openvalence/Hardware/flagship/ossm-flagship.kicad_sch

## KiCad design flagship/ossm-flagship.kicad_sch (2026-09-24)

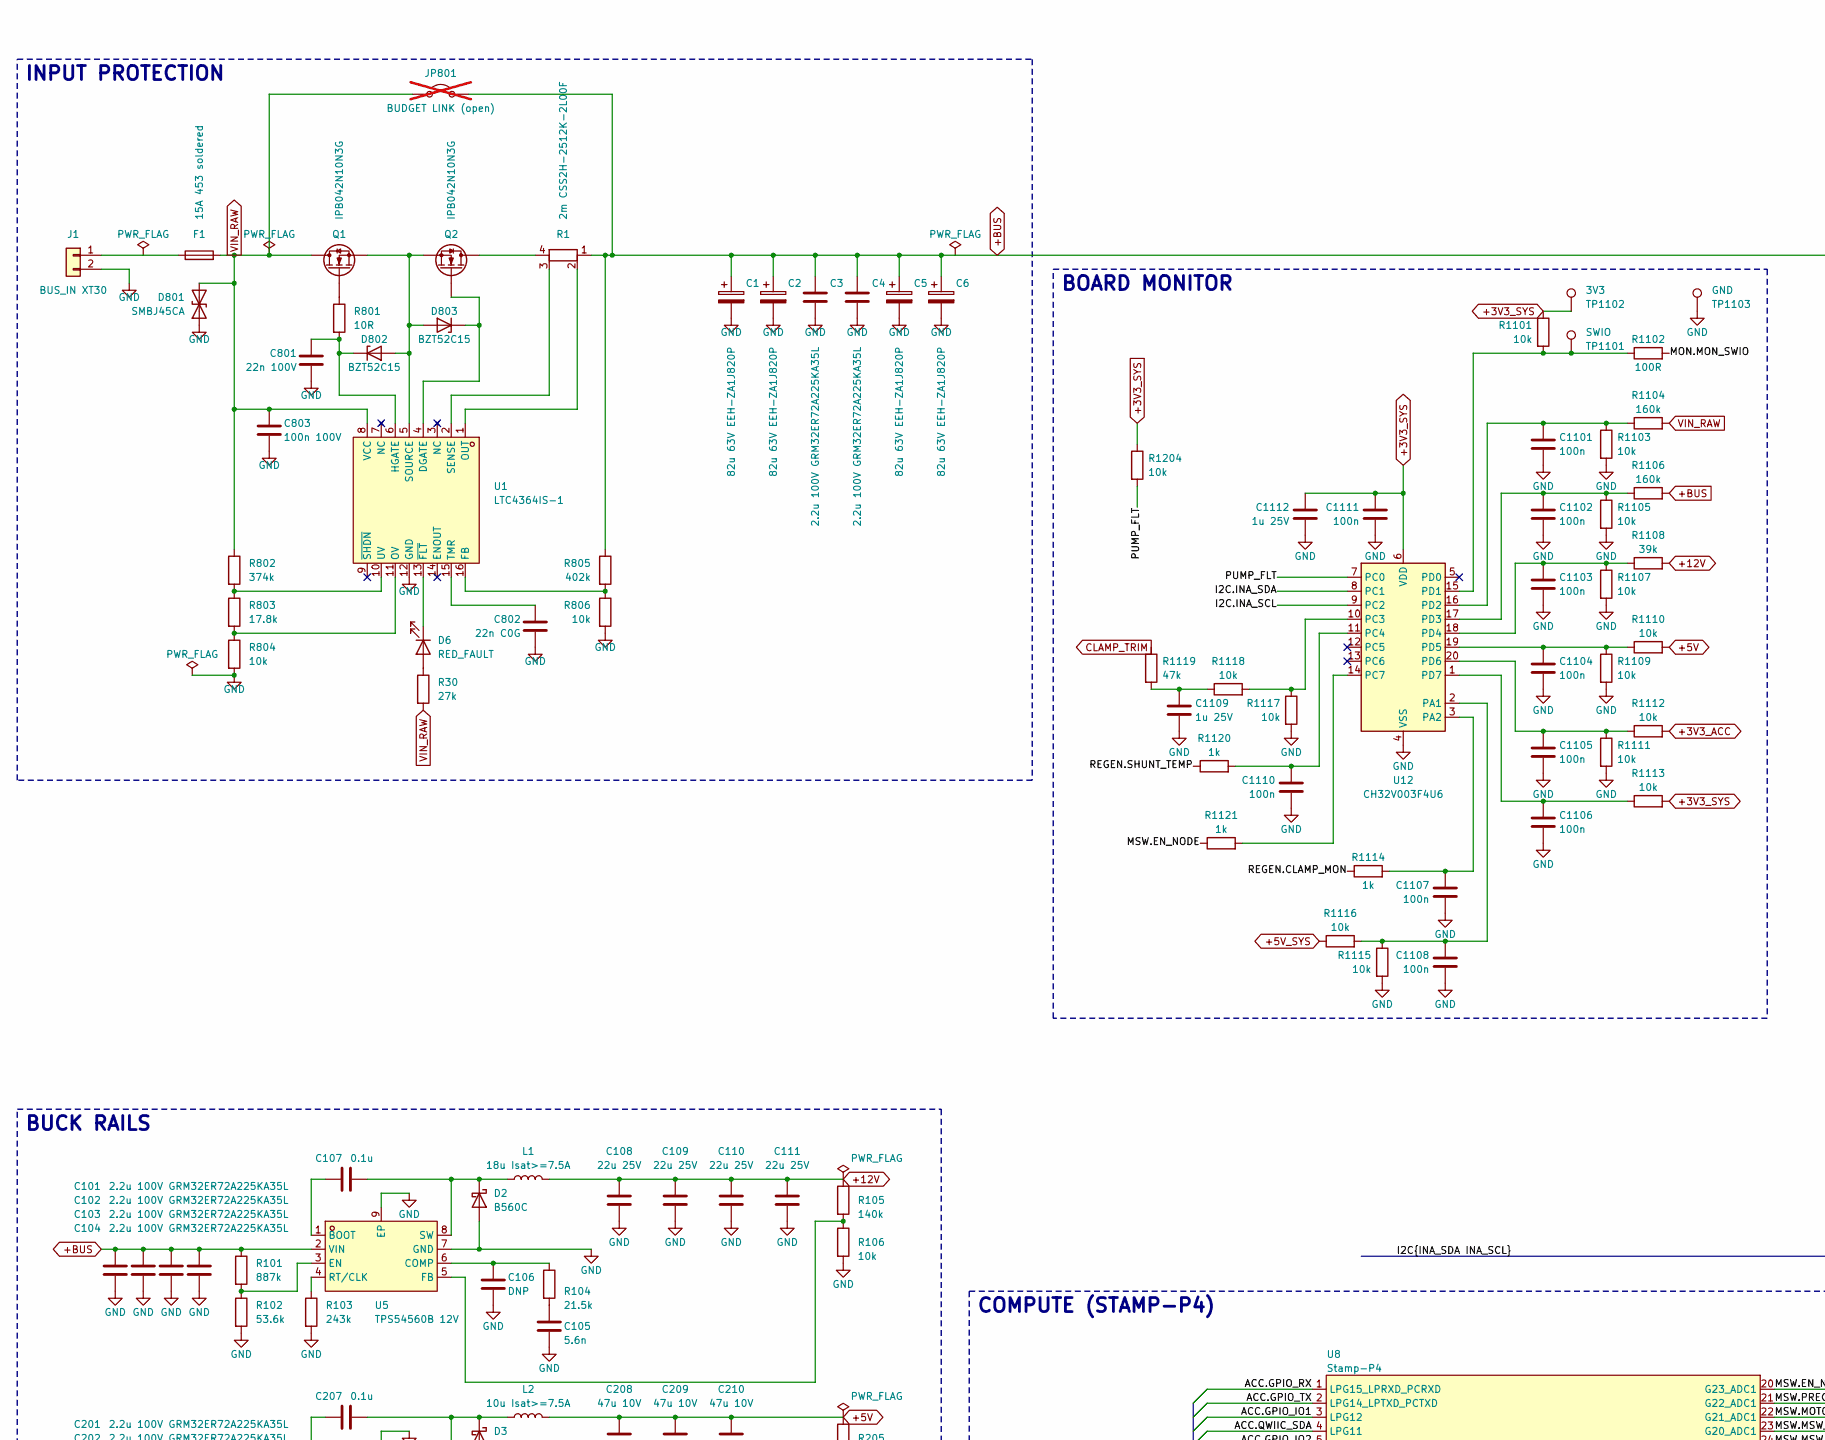
[picture p1: schematic ossm-flagship.kicad_sch, part in row 1, column 1]

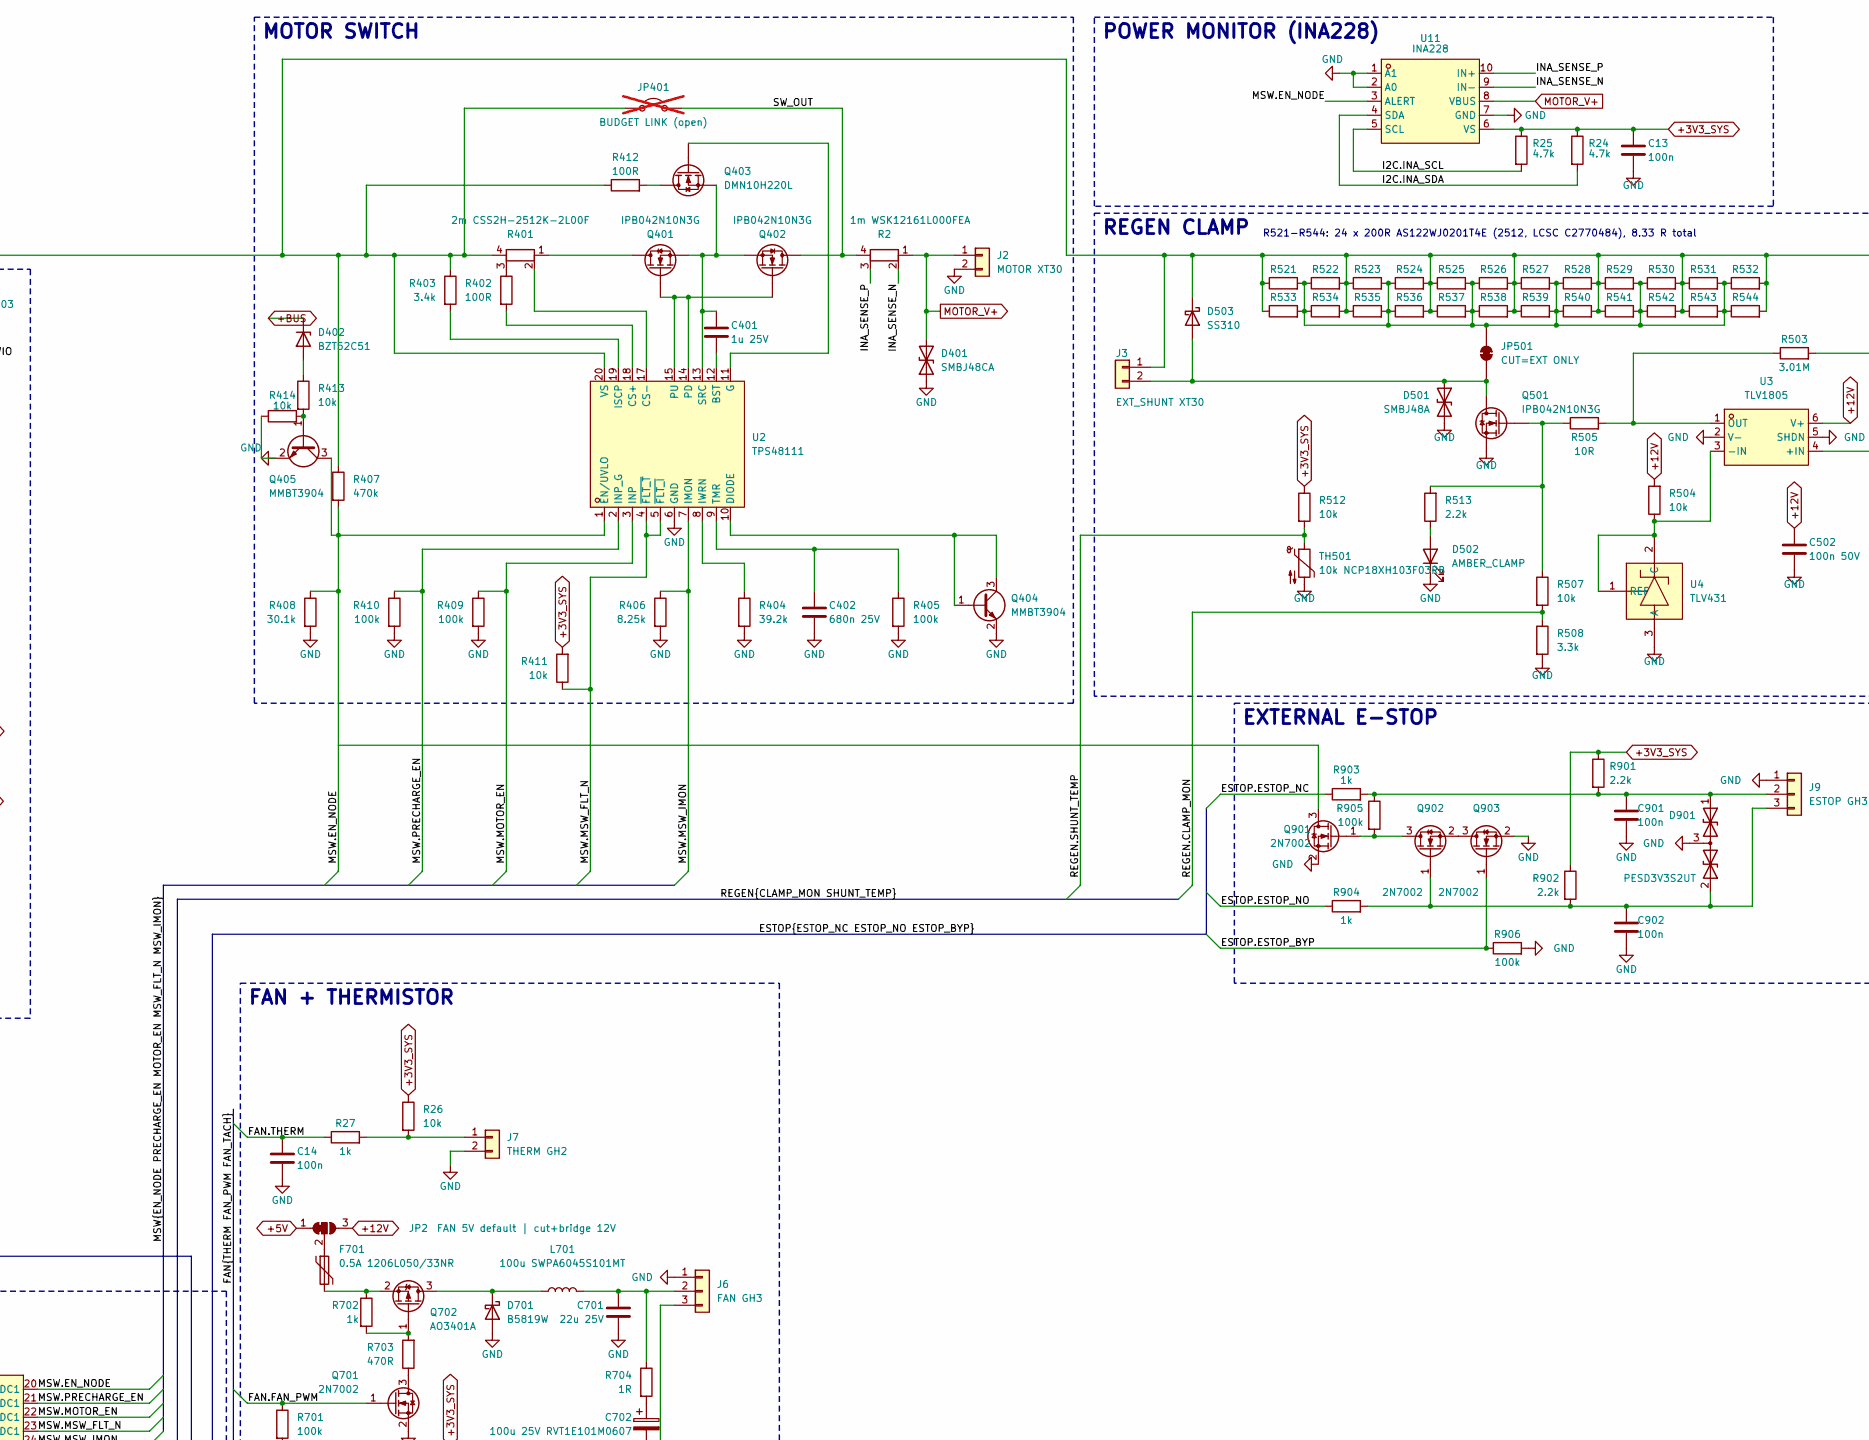
[picture p2: schematic ossm-flagship.kicad_sch, part in row 1, column 2]

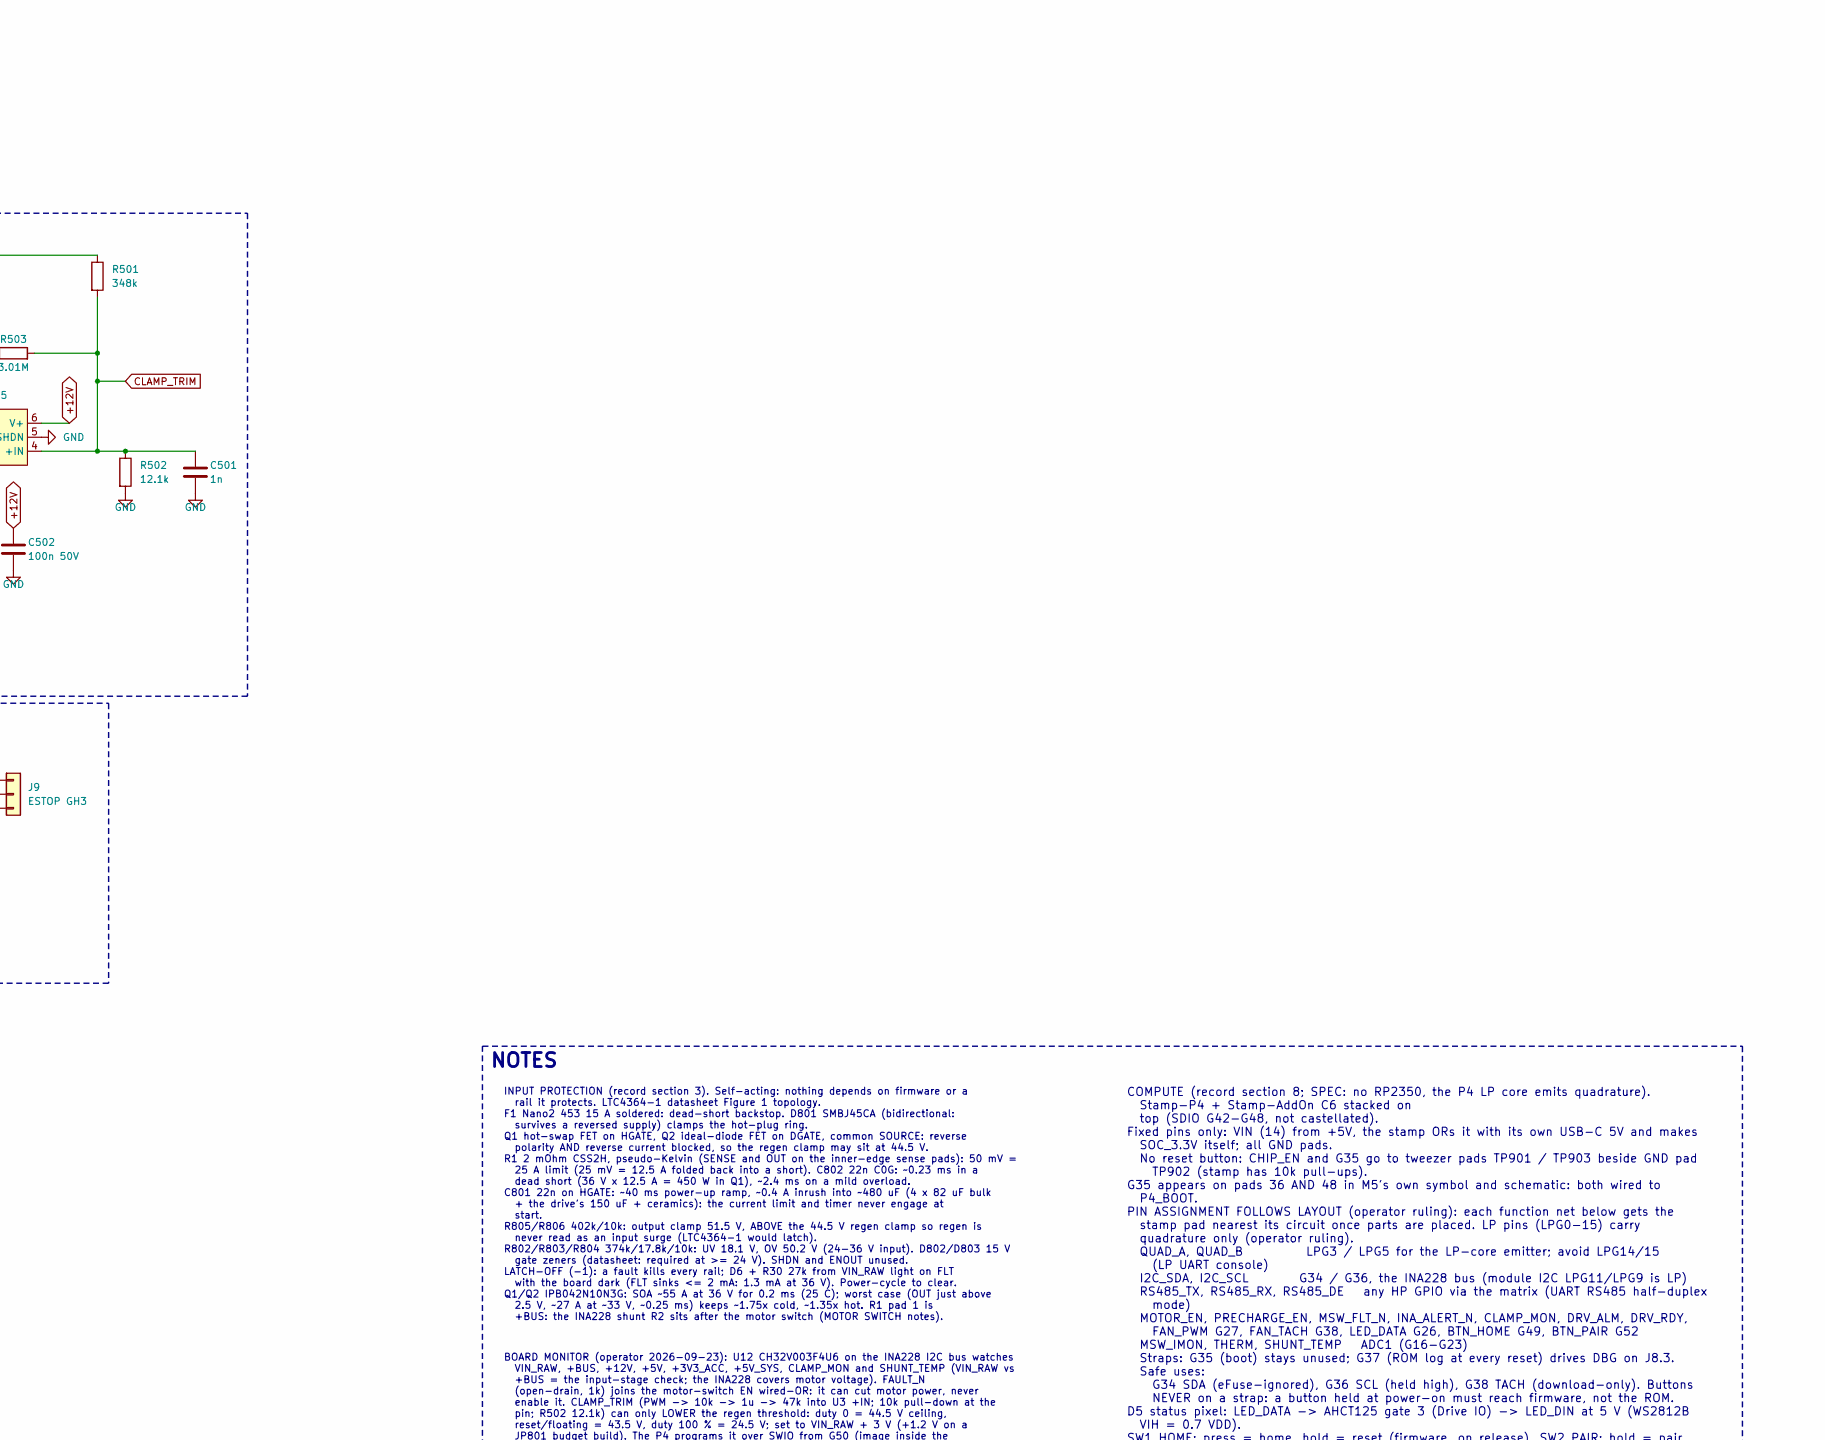
[picture p3: schematic ossm-flagship.kicad_sch, part in row 1, column 3]

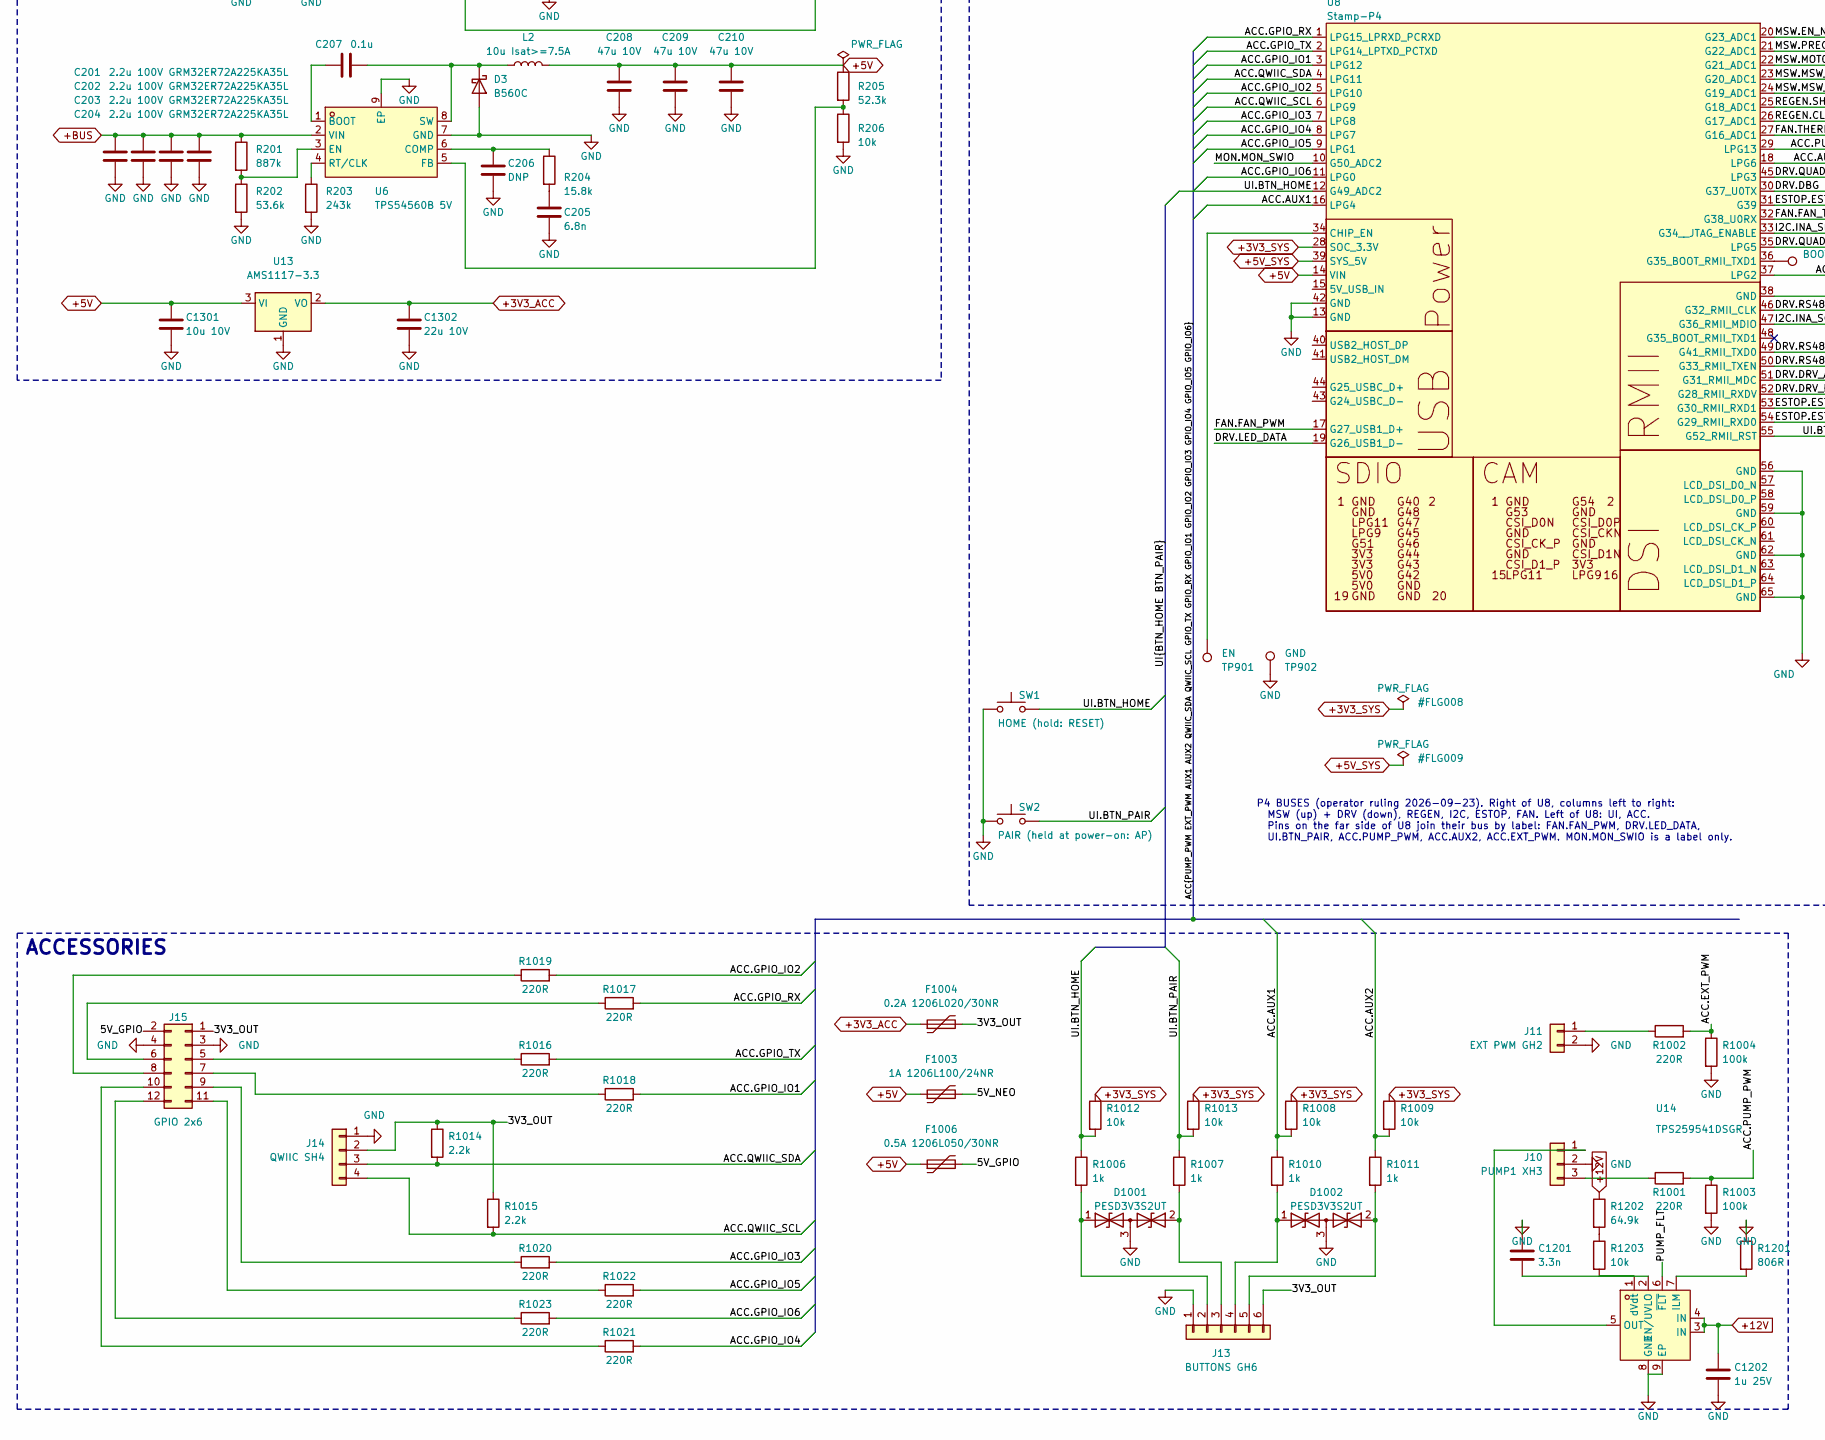
[picture p4: schematic ossm-flagship.kicad_sch, part in row 2, column 1]

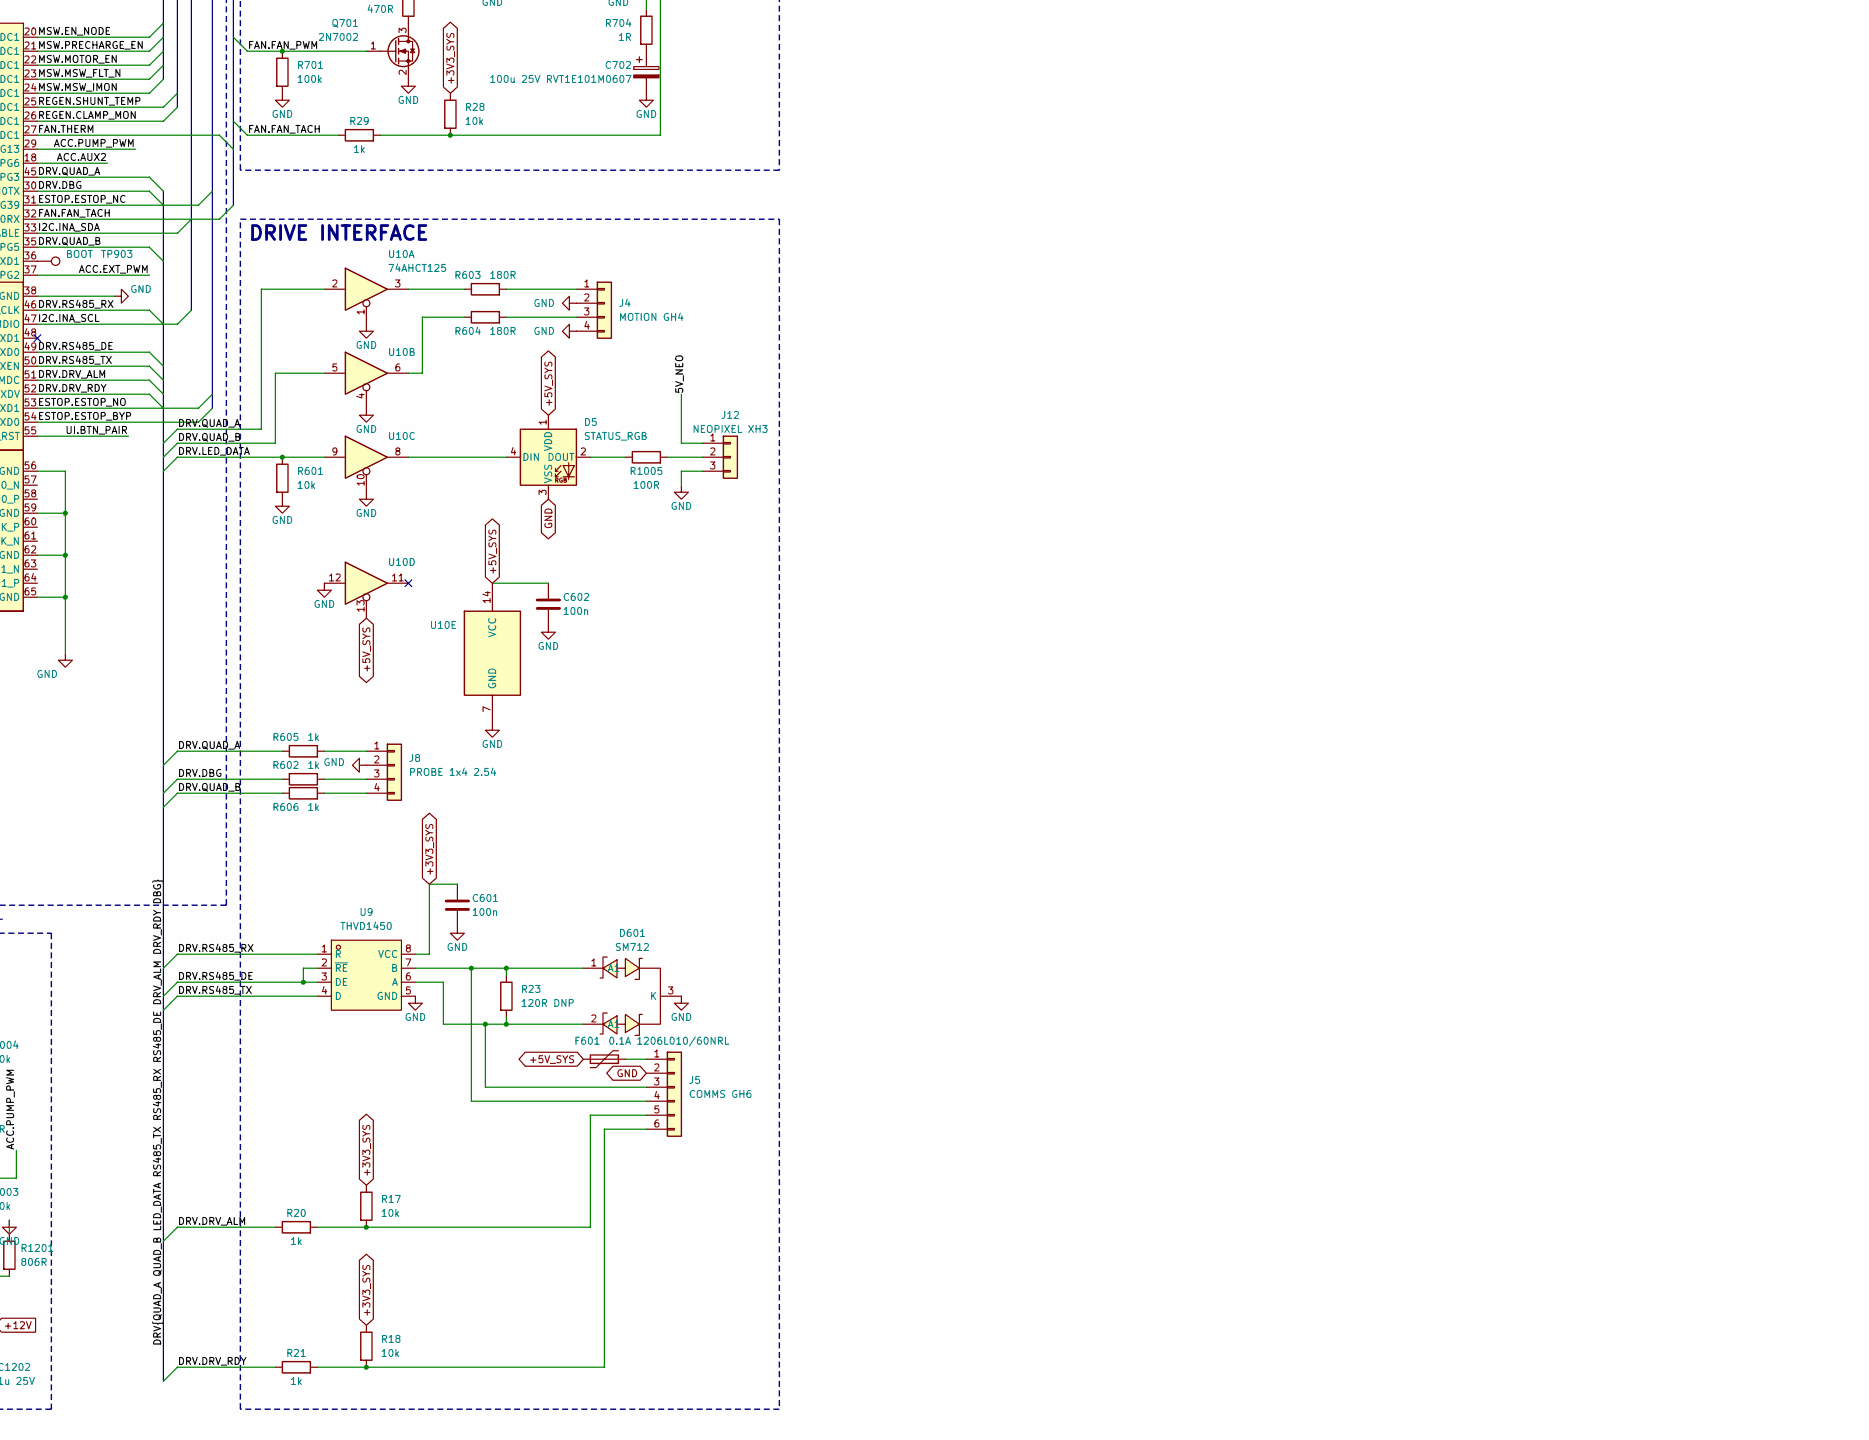
[picture p5: schematic ossm-flagship.kicad_sch, part in row 2, column 2]

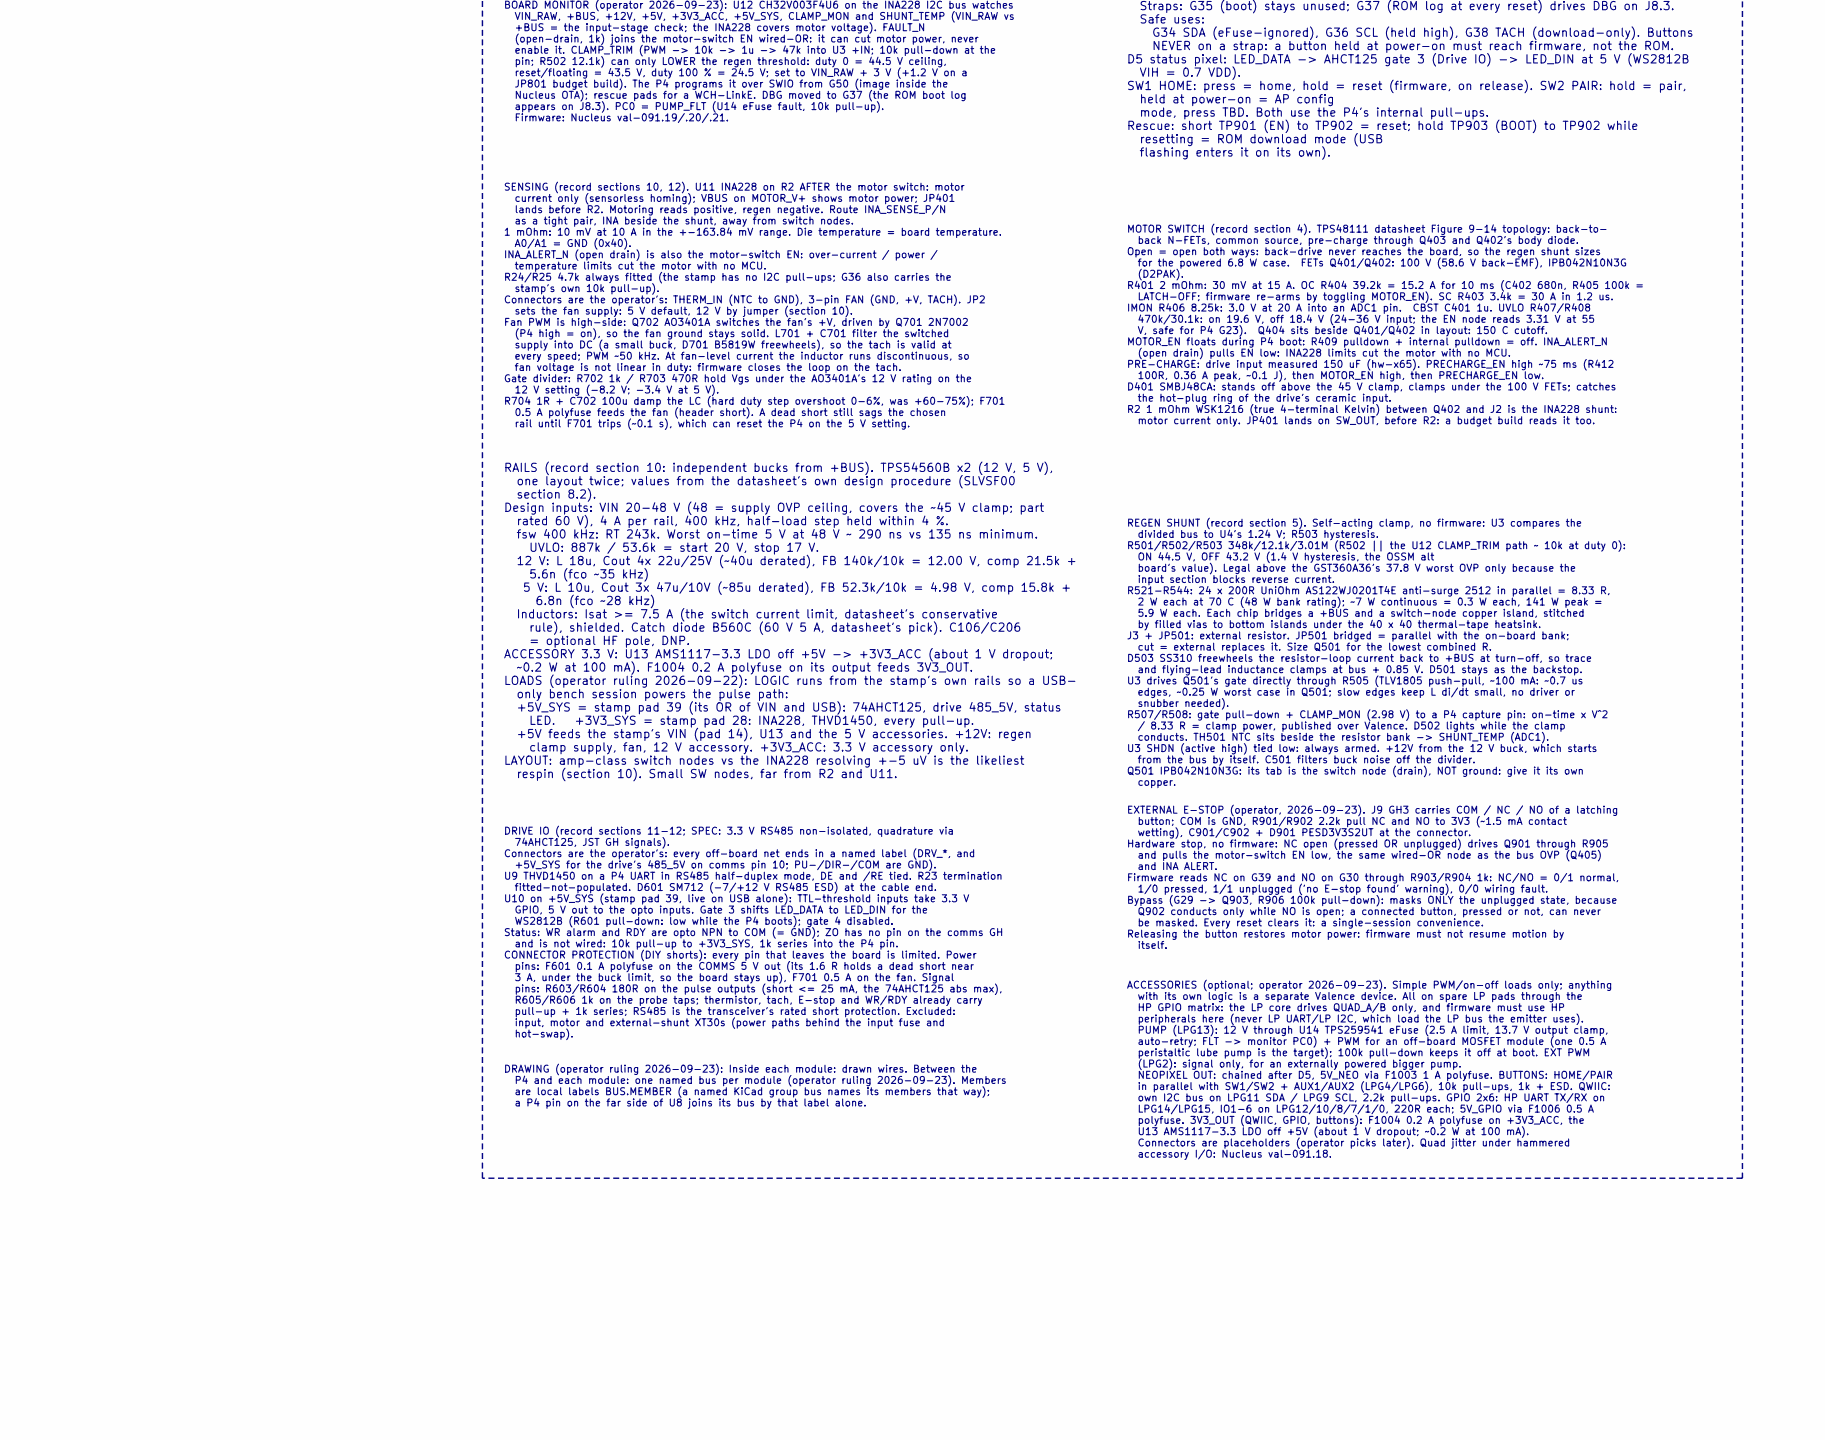
[picture p6: schematic ossm-flagship.kicad_sch, part in row 2, column 3]

Parts:
C1, C2, C5, C6: 82u 63V EEH-ZA1J820P; CP_Elec_10x10.5
C3, C4, C101, C102, C103, C104, C201, C202, C203, C204: 2.2u 100V GRM32ER72A225KA35L; C_1210_3225Metric
C13, C14, C601, C602, C901, C902, C1101, C1102, C1103, C1104, C1105, C1106, C1107, C1108, C1110, C1111: 100n; C_0805_2012Metric
C105: 5.6n; C_0805_2012Metric
C106, C206: DNP; C_0805_2012Metric
C107, C207: 0.1u; C_0805_2012Metric
C108, C109, C110, C111: 22u 25V; C_1210_3225Metric
C205: 6.8n; C_0805_2012Metric
C208, C209, C210: 47u 10V; C_1210_3225Metric
C401, C1109, C1112, C1202: 1u 25V; C_0805_2012Metric
C402: 680n 25V; C_0805_2012Metric
C501: 1n; C_0805_2012Metric
C502: 100n 50V; C_0805_2012Metric
C701: 22u 25V; C_1206_3216Metric; LCSC Part C12891
C702: 100u 25V RVT1E101M0607; CP_Elec_6.3x7.7; LCSC Part C72477
C801: 22n 100V; C_0805_2012Metric
C802: 22n C0G; C_0805_2012Metric
C803: 100n 100V; C_1206_3216Metric
C1201: 3.3n; C_0805_2012Metric
C1301: 10u 10V; C_0805_2012Metric
C1302: 22u 10V; C_0805_2012Metric
D2, D3: B560C; D_SMC
D5: STATUS_RGB; LED_WS2812B_PLCC4_5.0x5.0mm_P3.2mm
D6: RED_FAULT; LED_1206_3216Metric
D401: SMBJ48CA; D_SMB
D402: BZT52C51; D_SOD-123
D501: SMBJ48A; D_SMB
D502: AMBER_CLAMP; LED_0805_2012Metric
D503: SS310; D_SMA
D601: SM712; SOT-23-3_L3.0-W1.7-P0.95-LS2.9-BR
D701: B5819W; D_SOD-123; LCSC Part C8598
D801: SMBJ45CA; D_SMB
D802, D803: BZT52C15; D_SOD-123
D901, D1001, D1002: PESD3V3S2UT; SOT-23; LCSC Part C84276
F1: 15A 453 soldered; Fuse_Littelfuse-NANO2-451_453
F601: 0.1A 1206L010/60NRL; Fuse_1206_3216Metric; LCSC Part C18198325
F701: 0.5A 1206L050/33NR; Fuse_1206_3216Metric; LCSC Part C19193043
F1003: 1A 1206L100/24NR; Fuse_1206_3216Metric; LCSC Part C7542957
F1004: 0.2A 1206L020/30NR; Fuse_1206_3216Metric; LCSC Part C7542932
F1006: 0.5A 1206L050/30NR; Fuse_1206_3216Metric; LCSC Part C7542947
J1: BUS_IN XT30; CONN-TH_XT30PW-M
J2: MOTOR XT30; CONN-TH_XT30PW-M
J3: EXT_SHUNT XT30; CONN-TH_XT30PW-M
J4: MOTION GH4; JST_GH_SM04B-GHS-TB_1x04-1MP_P1.25mm_Horizontal
J5: COMMS GH6; JST_GH_SM06B-GHS-TB_1x06-1MP_P1.25mm_Horizontal
J6: FAN GH3; JST_GH_SM03B-GHS-TB_1x03-1MP_P1.25mm_Horizontal
J7: THERM GH2; JST_GH_SM02B-GHS-TB_1x02-1MP_P1.25mm_Horizontal
J8: PROBE 1x4 2.54; PinHeader_1x04_P2.54mm_Vertical
J9: ESTOP GH3; JST_GH_SM03B-GHS-TB_1x03-1MP_P1.25mm_Horizontal
J10: PUMP1 XH3; JST_XH_B3B-XH-A_1x03_P2.50mm_Vertical
J11: EXT PWM GH2; JST_GH_SM02B-GHS-TB_1x02-1MP_P1.25mm_Horizontal
J12: NEOPIXEL XH3; JST_XH_B3B-XH-A_1x03_P2.50mm_Vertical
J13: BUTTONS GH6; JST_GH_SM06B-GHS-TB_1x06-1MP_P1.25mm_Horizontal
J14: QWIIC SH4; JST_SH_SM04B-SRSS-TB_1x04-1MP_P1.00mm_Horizontal
J15: GPIO 2x6; PinHeader_2x06_P2.54mm_Vertical
JP2: FAN 5V default | cut+bridge 12V; SolderJumper-3_P1.3mm_Bridged12_RoundedPad1.0x1.5mm_NumberL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
JP401, JP801: BUDGET LINK (open); Link_Wire_15A; not fitted
JP501: CUT=EXT ONLY
L1: 18u Isat>=7.5A
L2: 10u Isat>=7.5A
L701: 100u SWPA6045S101MT; L_Sunlord_SWPA6045S; LCSC Part C60633
Q1, Q2, Q401, Q402, Q501: IPB042N10N3G; TO-263-2
Q403: DMN10H220L; SOT-23
Q404, Q405: MMBT3904; SOT-23
Q701, Q901, Q902, Q903: 2N7002; SOT-23
Q702: AO3401A; SOT-23; LCSC Part C15127
R1, R401: 2m CSS2H-2512K-2L00F; R_2512_Shunt_PseudoKelvin
R2: 1m WSK12161L000FEA; R_Shunt_Vishay_WSK1216_Kelvin
R17, R18, R26, R28, R106, R206, R411, R413, R414, R504, R507, R512, R601, R804, R806, R1008, R1009, R1012, R1013, R1101, R1103, R1105, R1107, R1109, R1110, R1111, R1112, R1113, R1115, R1116, R1117, R1118, R1203, R1204: 10k; R_0805_2012Metric
R20, R21, R27, R29, R602, R605, R606, R702, R903, R904, R1006, R1007, R1010, R1011, R1114, R1120, R1121: 1k; R_0805_2012Metric
R23: 120R DNP; R_0805_2012Metric
R24, R25: 4.7k; R_0805_2012Metric
R30: 27k; R_1206_3216Metric
R101, R201: 887k; R_0805_2012Metric
R102, R202: 53.6k; R_0805_2012Metric
R103, R203: 243k; R_0805_2012Metric
R104: 21.5k; R_0805_2012Metric
R105: 140k; R_0805_2012Metric
R204: 15.8k; R_0805_2012Metric
R205: 52.3k; R_0805_2012Metric
R402, R1005, R1102: 100R; R_0805_2012Metric
R403: 3.4k; R_0805_2012Metric
R404: 39.2k; R_0805_2012Metric
R405, R409, R410, R701, R905, R906, R1003, R1004: 100k; R_0805_2012Metric
R406: 8.25k; R_0805_2012Metric
R407: 470k; R_1206_3216Metric
R408: 30.1k; R_0805_2012Metric
R412: 100R; R_2512_6332Metric
R501: 348k; R_1206_3216Metric
R502: 12.1k; R_0805_2012Metric
R503: 3.01M; R_0805_2012Metric
R505, R801: 10R; R_0805_2012Metric
R508: 3.3k; R_0805_2012Metric
R513, R901, R902, R1014, R1015: 2.2k; R_0805_2012Metric
R521, R522, R523, R524, R525, R526, R527, R528, R529, R530, R531, R532, R533, R534, R535, R536, R537, R538, R539, R540, R541, R542, R543, R544: 200R AS122WJ0201T4E; R_2512_6332Metric; MPN AS122WJ0201T4E; LCSC Part C2770484
R603, R604: 180R; R_0805_2012Metric
R703: 470R; R_0805_2012Metric
R704: 1R; R_1206_3216Metric
R802: 374k; R_1206_3216Metric
R803: 17.8k; R_0805_2012Metric
R805: 402k; R_1206_3216Metric
R1001, R1002, R1016, R1017, R1018, R1019, R1020, R1021, R1022, R1023: 220R; R_0805_2012Metric
R1104, R1106: 160k; R_1206_3216Metric
R1108: 39k; R_0805_2012Metric
R1119: 47k; R_0805_2012Metric
R1201: 806R; R_0805_2012Metric
R1202: 64.9k; R_0805_2012Metric
SW1: HOME (hold: RESET)
SW2: PAIR (held at power-on: AP)
TH501: 10k NCP18XH103F03RB; R_0603_1608Metric
TP901: EN; TestPoint_Pad_D1.5mm
TP902, TP1103: GND; TestPoint_Pad_D1.5mm
TP903: BOOT; TestPoint_Pad_D1.5mm
TP1101: SWIO; TestPoint_Pad_D1.5mm
TP1102: 3V3; TestPoint_Pad_D1.5mm
U1: LTC4364IS-1; SOIC-16_L9.9-W3.9-P1.27-LS6.0-BL-1
U2: TPS48111; VSSOP-20_19P-L5.0-W3.0-P0.50-LS5.0-BL_PE16
U3: TLV1805; TSOT-23-6_L2.9-W1.6-P0.95-LS2.8-BL
U4: TLV431; SOT-23-3_L2.9-W1.3-P1.90-LS2.4-BR
U5: TPS54560B 12V; POWERPAD-SO-8_L4.9-W3.9-P1.27-LS6.0-BL-EP
U6: TPS54560B 5V; POWERPAD-SO-8_L4.9-W3.9-P1.27-LS6.0-BL-EP
U8: Stamp-P4
U9: THVD1450; SOIC-8_L4.9-W3.9-P1.27-LS6.0-BL
U10: 74AHCT125; TSSOP-14_4.4x5mm_P0.65mm
U11: INA228; VSSOP-10_L3.0-W3.0-P0.50-LS4.9-BL
U12: CH32V003F4U6; QFN-20-1EP_3x3mm_P0.4mm_EP1.65x1.65mm; LCSC Part C5299908
U13: AMS1117-3.3; SOT-223-3_TabPin2; LCSC Part C6186
U14: TPS259541DSGR; Texas_DSG0008A_WSON-8-1EP_2x2mm_P0.5mm_EP0.9x1.6mm; LCSC Part C2155673

Connections:
3V3_OUT: F1004.2, J13.6, J14.2, J15.1, R1014.1, R1015.1
5V_GPIO: F1006.2, J15.2
5V_NEO: F1003.2, J12.1
+3V3_ACC: C1302.1, F1004.1, R1112.2, U13.2 (VO)
+3V3_SYS: C13.1, C601.1, C1111.1, C1112.1, R17.1, R18.1, R24.1, R25.1, R26.1, R28.1, R411.2, R512.1, R901.1, R902.1, R1008.1, R1009.1, R1012.1, R1013.1, R1101.1, R1113.2, R1204.1, TP1102.1, U8.28 (SOC_3.3V), U9.8 (VCC), U11.6 (VS), U12.6 (VDD)
+5V: C208.1, C209.1, C210.1, C1301.1, F1003.1, F1006.1, JP2.1 (A), L2.2, R205.1, R1110.2, U8.14 (VIN), U13.3 (VI)
+5V_SYS: C602.1, D5.1 (VDD), F601.1, R1116.1, U8.39 (SYS_5V), U10.13, U10.14 (VCC)
+12V: C108.1, C109.1, C110.1, C111.1, C502.1, C1202.1, JP2.3 (B), L1.2, R105.1, R504.2, R1108.2, R1202.1, U3.6 (V+), U14.3 (IN), U14.4 (IN)
+BUS: C1.1, C2.1, C3.1, C4.1, C5.1, C6.1, C101.1, C102.1, C103.1, C104.1, C201.1, C202.1, C203.1, C204.1, D402.1 (K), D503.1 (K), J3.1, JP401.1 (A), JP801.2 (B), R1.1, R101.1, R201.1, R401.4, R403.1, R407.1, R412.1, R501.1, R521.1, R522.2, R523.1, R524.2, R525.1, R526.2, R527.1, R528.2, R529.1, R530.2, R531.1, R532.2, R533.1, R534.2, R535.1, R536.2, R537.1, R538.2, R539.1, R540.2, R541.1, R542.2, R543.1, R544.2, R805.1, R1106.2, U2.20 (VS), U5.2 (VIN), U6.2 (VIN)
ACC.AUX1: R1008.2, R1010.1, U8.16 (LPG4)
ACC.AUX2: R1009.2, R1011.1, U8.18 (LPG6)
ACC.EXT_PWM: R1002.2, R1004.1, U8.37 (LPG2)
ACC.GPIO_IO1: R1018.2, U8.3 (LPG12)
ACC.GPIO_IO2: R1019.2, U8.5 (LPG10)
ACC.GPIO_IO3: R1020.2, U8.7 (LPG8)
ACC.GPIO_IO4: R1021.2, U8.8 (LPG7)
ACC.GPIO_IO5: R1022.2, U8.9 (LPG1)
ACC.GPIO_IO6: R1023.2, U8.11 (LPG0)
ACC.GPIO_RX: R1017.2, U8.1 (LPG15_LPRXD_PCRXD)
ACC.GPIO_TX: R1016.2, U8.2 (LPG14_LPTXD_PCTXD)
ACC.PUMP_PWM: R1001.2, R1003.1, U8.29 (LPG13)
ACC.QWIIC_SCL: J14.4, R1015.2, U8.6 (LPG9)
ACC.QWIIC_SDA: J14.3, R1014.2, U8.4 (LPG11)
CLAMP_TRIM: C501.1, R501.2, R502.1, R503.2, R1119.1, U3.4 (+IN)
DRV.DBG: R602.2, U8.30 (G37_U0TX)
DRV.DRV_ALM: R20.1, U8.51 (G31_RMII_MDC)
DRV.DRV_RDY: R21.1, U8.52 (G28_RMII_RXDV)
DRV.LED_DATA: R601.1, U8.19 (G26_USB1_D-), U10.9
DRV.QUAD_A: R605.1, U8.45 (LPG3), U10.2
DRV.QUAD_B: R606.1, U8.35 (LPG5), U10.5
DRV.RS485_DE: U8.49 (G41_RMII_TXD0), U9.2 (~RE), U9.3 (DE)
DRV.RS485_RX: U8.46 (G32_RMII_CLK), U9.1 (R)
DRV.RS485_TX: U8.50 (G33_RMII_TXEN), U9.4 (D)
ESTOP.ESTOP_BYP: Q903.1 (G), R906.1, U8.54 (G29_RMII_RXD0)
ESTOP.ESTOP_NC: R903.1, U8.31 (G39)
ESTOP.ESTOP_NO: R904.1, U8.53 (G30_RMII_RXD1)
FAN.FAN_PWM: Q701.1 (G), R701.1, U8.17 (G27_USB1_D+)
FAN.FAN_TACH: R29.1, U8.32 (G38_U0RX)
FAN.THERM: C14.1, R27.1, U8.27 (G16_ADC1)
GND: C1.2, C2.2, C3.2, C4.2, C5.2, C6.2, C13.2, C14.2, C101.2, C102.2, C103.2, C104.2, C105.2, C106.2, C108.2, C109.2, C110.2, C111.2, C201.2, C202.2, C203.2, C204.2, C205.2, C206.2, C208.2, C209.2, C210.2, C402.2, C501.2, C502.2, C601.2, C602.2, C701.2, C702.2, C801.2, C802.2, C803.2, C901.2, C902.2, C1101.2, C1102.2, C1103.2, C1104.2, C1105.2, C1106.2, C1107.2, C1108.2, C1109.2, C1110.2, C1111.2, C1112.2, C1201.1, C1202.2, C1301.2, C1302.2, D2.2 (A), D3.2 (A), D5.3 (VSS), D401.1 (A1), D501.2 (A2), D502.1 (K), D601.3 (K), D701.2 (A), D801.1 (A1), D901.3 (common), D1001.3 (common), D1002.3 (common), J1.2, J2.2, J4.2, J4.4, J5.2, J6.1, J7.2, J8.2, J9.1, J10.2, J11.2, J12.3, J13.1, J14.1, J15.3, J15.4, Q404.2 (E), Q405.2 (E), Q501.3 (S), Q701.2 (S), Q901.2 (S), Q903.2 (S), R102.2, R103.2, R106.2, R202.2, R203.2, R206.2, R404.2, R405.2, R406.2, R408.2, R409.2, R410.2, R414.1, R502.2, R508.2, R601.2, R701.2, R804.2, R806.2, R906.2, R1003.2, R1004.2, R1103.2, R1105.2, R1107.2, R1109.2, R1111.2, R1115.2, R1117.2, R1201.1, SW1.1, SW2.1, TH501.2, TP902.1, TP1103.1, U1.12 (GND), U2.6 (GND), U3.2 (V-), U3.5 (SHDN), U4.3 (A), U5.7 (GND), U5.9 (EP), U6.7 (GND), U6.9 (EP), U8.13 (GND), U8.38 (GND), U8.42 (GND), U8.56 (GND), U8.59 (GND), U8.62 (GND), U8.65 (GND), U9.5 (GND), U10.1, U10.4, U10.7 (GND), U10.10, U10.12, U11.1 (A1), U11.2 (A0), U11.7 (GND), U12.4 (VSS), U12.21 (VSS), U13.1 (GND), U14.8 (GND), U14.9 (EP)
I2C.INA_SCL: R25.2, U8.47 (G36_RMII_MDIO), U11.5 (SCL), U12.9 (PC2)
I2C.INA_SDA: R24.2, U8.33 (G34__JTAG_ENABLE), U11.4 (SDA), U12.8 (PC1)
INA_SENSE_N: R2.2, U11.9 (IN-)
INA_SENSE_P: R2.3, U11.10 (IN+)
MON.MON_SWIO: R1102.2, U8.10 (G50_ADC2)
MOTOR_V+: D401.2 (A2), J2.1, R2.1, U11.8 (VBUS)
MSW.EN_NODE: Q405.3 (C), Q901.3 (D), R407.2, R408.1, R1121.1, U2.1 (EN/UVLO), U8.20 (G23_ADC1), U11.3 (ALERT)
MSW.MOTOR_EN: R409.1, U2.3 (INP), U8.22 (G21_ADC1)
MSW.MSW_FLT_N: R411.1, U2.4 (~FLT_T), U2.5 (~FLT_I), U8.23 (G20_ADC1)
MSW.MSW_IMON: R406.1, U2.7 (IMON), U8.24 (G19_ADC1)
MSW.PRECHARGE_EN: R410.1, U2.2 (INP_G), U8.21 (G22_ADC1)
unnamed: C105.1, R104.2
unnamed: C106.1, R104.1, U5.6 (COMP)
unnamed: C107.1, U5.1 (BOOT)
unnamed: C107.2, D2.1 (K), L1.1, U5.8 (SW)
unnamed: C205.1, R204.2
unnamed: C206.1, R204.1, U6.6 (COMP)
unnamed: C207.1, U6.1 (BOOT)
unnamed: C207.2, D3.1 (K), L2.1, U6.8 (SW)
unnamed: C401.1, Q401.3 (S), Q402.3 (S), Q403.2 (S), U2.13 (SRC)
unnamed: C401.2, U2.12 (BST)
unnamed: C402.1, R405.1, U2.9 (TMR)
unnamed: C701.1, J6.2, L701.2, R704.1
unnamed: C702.1, R704.2
unnamed: C801.1, D802.1 (K), R801.2, U1.6 (HGATE)
unnamed: C802.1, U1.15 (TMR)
unnamed: C901.1, D901.1 (A1), J9.2, R901.2, R903.2, R905.1
unnamed: C902.1, D901.2 (A2), J9.3, Q902.1 (G), R902.2, R904.2
unnamed: C1101.1, R1103.1, R1104.1, U12.16 (PD2)
unnamed: C1102.1, R1105.1, R1106.1, U12.17 (PD3)
unnamed: C1103.1, R1107.1, R1108.1, U12.18 (PD4)
unnamed: C1104.1, R1109.1, R1110.1, U12.19 (PD5)
unnamed: C1105.1, R1111.1, R1112.1, U12.20 (PD6)
unnamed: C1106.1, R1113.1, U12.1 (PD7)
unnamed: C1107.1, R1114.2, U12.3 (PA2)
unnamed: C1108.1, R1115.1, R1116.2, U12.2 (PA1)
unnamed: C1109.1, R1118.1, R1119.2
unnamed: C1110.1, R1120.2, U12.11 (PC4)
unnamed: C1201.2, U14.1 (dVdt)
unnamed: D5.2 (DOUT), R1005.1
unnamed: D5.4 (DIN), U10.8
unnamed: D6.1 (K), U1.13 (~FLT)
unnamed: D6.2 (A), R30.1
unnamed: D402.2 (A), R413.1
unnamed: D501.1 (A1), D503.2 (A), J3.2, JP501.1 (A), Q501.2 (D)
unnamed: D502.2 (A), R513.1
unnamed: D601.1 (A1), J5.4, R23.1, U9.7 (B)
unnamed: D601.2 (A1), J5.3, R23.2, U9.6 (A)
unnamed: D701.1 (K), L701.1, Q702.3 (D)
unnamed: D802.2 (A), D803.2 (A), Q1.3 (S), Q2.3 (S), U1.5 (SOURCE)
unnamed: D803.1 (K), Q2.1 (G), U1.4 (DGATE)
unnamed: D1001.1 (A1), J13.2, R1006.2
unnamed: D1001.2 (A2), J13.3, R1007.2
unnamed: D1002.1 (A1), J13.4, R1010.2
unnamed: D1002.2 (A2), J13.5, R1011.2
unnamed: F1.1, J1.1
unnamed: F601.2, J5.1
unnamed: F701.1, JP2.2 (C)
unnamed: F701.2, Q702.2 (S), R702.1
unnamed: J4.1, R603.2
unnamed: J4.3, R604.2
unnamed: J5.5, R17.2, R20.2
unnamed: J5.6, R18.2, R21.2
unnamed: J6.3, R28.2, R29.2
unnamed: J7.1, R26.2, R27.2
unnamed: J8.1, R605.2
unnamed: J8.3, R602.1
unnamed: J8.4, R606.2
unnamed: J10.1, U14.5 (OUT)
unnamed: J10.3, R1001.1
unnamed: J11.1, R1002.1
unnamed: J12.2, R1005.2
unnamed: J15.5, R1016.1
unnamed: J15.6, R1017.1
unnamed: J15.7, R1018.1
unnamed: J15.8, R1019.1
unnamed: J15.9, R1020.1
unnamed: J15.10, R1021.1
unnamed: J15.11, R1022.1
unnamed: J15.12, R1023.1
unnamed: JP501.2 (B), R521.2, R522.1, R523.2, R524.1, R525.2, R526.1, R527.2, R528.1, R529.2, R530.1, R531.2, R532.1, R533.2, R534.1, R535.2, R536.1, R537.2, R538.1, R539.2, R540.1, R541.2, R542.1, R543.2, R544.1
unnamed: Q1.1 (G), R801.1
unnamed: Q2.2 (D), R1.4
unnamed: Q401.1 (G), Q402.1 (G), U2.14 (PD), U2.15 (PU)
unnamed: Q401.2 (D), R401.1
unnamed: Q403.1 (G), U2.11 (G)
unnamed: Q403.3 (D), R412.2
unnamed: Q404.1 (B), Q404.3 (C), U2.10 (DIODE)
unnamed: Q405.1 (B), R413.2, R414.2
unnamed: Q501.1 (G), R505.1, R507.1, R513.2
unnamed: Q701.3 (D), R703.1
unnamed: Q702.1 (G), R702.2, R703.2
unnamed: Q901.1 (G), Q902.3 (D), R905.2
unnamed: Q902.2 (S), Q903.3 (D)
unnamed: R1.2, U1.1 (OUT)
unnamed: R1.3, U1.2 (SENSE)
unnamed: R101.2, R102.1, U5.3 (EN)
unnamed: R103.1, U5.4 (RT/CLK)
unnamed: R105.2, R106.1, U5.5 (FB)
unnamed: R201.2, R202.1, U6.3 (EN)
unnamed: R203.1, U6.4 (RT/CLK)
unnamed: R205.2, R206.1, U6.5 (FB)
unnamed: R401.2, U2.17 (CS-)
unnamed: R401.3, R402.1
unnamed: R402.2, U2.18 (CS+)
unnamed: R403.2, U2.19 (ISCP)
unnamed: R404.1, U2.8 (IWRN)
unnamed: R503.1, R505.2, U3.1 (OUT)
unnamed: R504.1, U3.3 (-IN), U4.1 (REF), U4.2 (C)
unnamed: R603.1, U10.3
unnamed: R604.1, U10.6
unnamed: R802.2, R803.1, U1.10 (UV)
unnamed: R803.2, R804.1, U1.11 (OV)
unnamed: R805.2, R806.1, U1.16 (FB)
unnamed: R1101.2, R1102.1, TP1101.1, U12.15 (PD1)
unnamed: R1117.1, R1118.2, U12.10 (PC3)
unnamed: R1121.2, U12.14 (PC7)
unnamed: R1201.2, U14.7 (ILM)
unnamed: R1202.2, R1203.1
unnamed: R1203.2, U14.2 (EN/UVLO)
unnamed: TP901.1, U8.34 (CHIP_EN)
unnamed: TP903.1, U8.36 (G35_BOOT_RMII_TXD1)
PUMP_FLT: R1204.2, U12.7 (PC0), U14.6 (~FLT)
REGEN.CLAMP_MON: R507.2, R508.1, R1114.1, U8.26 (G17_ADC1)
REGEN.SHUNT_TEMP: R512.2, R1120.1, TH501.1, U8.25 (G18_ADC1)
SW_OUT: JP401.2 (B), Q402.2 (D), R2.4
UI.BTN_HOME: R1006.1, R1012.2, SW1.2, U8.12 (G49_ADC2)
UI.BTN_PAIR: R1007.1, R1013.2, SW2.2, U8.55 (G52_RMII_RST)
VIN_RAW: C803.1, D801.2 (A2), F1.2, JP801.1 (A), Q1.2 (D), R30.2, R802.1, R1104.2, U1.8 (VCC)

Notes on the sheet:
R521-R544: 24 x 200R AS122WJ0201T4E (2512, LCSC C2770484), 8.33 R total
DRIVE INTERFACE
SENSING (record sections 10, 12). U11 INA228 on R2 AFTER the motor switch: motor current only (sensorless homing); VBUS on MOTOR_V+ shows motor power; JP401 lands before R2. Motoring reads positive, regen negative. Route INA_SENSE_P/N as a tight pair, INA beside the shunt, away from switch nodes. 1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
REGEN CLAMP
BUCK RAILS
EXTERNAL E-STOP (operator, 2026-09-23). J9 GH3 carries COM / NC / NO of a latching button; COM is GND, R901/R902 2.2k pull NC and NO to 3V3 (~1.5 mA contact wetting), C901/C902 + D901 PESD3V3S2UT at the connector. Hardware stop, no firmware: NC open (pressed OR unplugged) drives Q901 through R905 a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
INPUT PROTECTION
FAN + THERMISTOR
P4 BUSES (operator ruling 2026-09-23). Right of U8, columns left to right: MSW (up) + DRV (down), REGEN, I2C, ESTOP, FAN. Left of U8: UI, ACC. Pins on the far side of U8 join their bus by label: FAN.FAN_PWM, DRV.LED_DATA, UI.BTN_PAIR, ACC.PUMP_PWM, ACC.AUX2, ACC.EXT_PWM. MON.MON_SWIO is a label onl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
BOARD MONITOR (operator 2026-09-23): U12 CH32V003F4U6 on the INA228 I2C bus watches VIN_RAW, +BUS, +12V, +5V, +3V3_ACC, +5V_SYS, CLAMP_MON and SHUNT_TEMP (VIN_RAW vs +BUS = the input-stage check; the INA228 covers motor voltage). FAULT_N (open-drain, 1k) joins the motor-switch EN wired-OR: it can c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
MOTOR SWITCH
INPUT PROTECTION (record section 3). Self-acting: nothing depends on firmware or a rail it protects. LTC4364-1 datasheet Figure 1 topology. F1 Nano2 453 15 A soldered: dead-short backstop. D801 SMBJ45CA (bidirectional: survives a reversed supply) clamps the hot-plug ring. Q1 hot-swap FET on HGATE, 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
NOTES
REGEN SHUNT (record section 5). Self-acting clamp, no firmware: U3 compares the divided bus to U4's 1.24 V; R503 hysteresis. R501/R502/R503 348k/12.1k/3.01M (R502 || the U12 CLAMP_TRIM path ~ 10k at duty 0): ON 44.5 V, OFF 43.2 V (1.4 V hysteresis, the OSSM alt board's value). Legal above the GST36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
ACCESSORIES (optional; operator 2026-09-23). Simple PWM/on-off loads only; anything with its own logic is a separate Valence device. All on spare LP pads through the HP GPIO matrix: the LP core drives QUAD_A/B only, and firmware must use HP peripherals here (never LP UART/LP I2C, which load the LP 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
DRIVE IO (record sections 11-12; SPEC: 3.3 V RS485 non-isolated, quadrature via 74AHCT125, JST GH signals). Connectors are the operator's: every off-board net ends in a named label (DRV_*, and +5V_SYS for the drive's 485_5V on comms pin 10; PU-/DIR-/COM are GND). U9 THVD1450 on a P4 UART in RS485 h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
EXTERNAL E-STOP
ACCESSORIES
RAILS (record section 10: independent bucks from +BUS). TPS54560B x2 (12 V, 5 V), one layout twice; values from the datasheet's own design procedure (SLVSF00 section 8.2). Design inputs: VIN 20-48 V (48 = supply OVP ceiling, covers the ~45 V clamp; part rated 60 V), 4 A per rail, 400 kHz, half-load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
DRAWING (operator ruling 2026-09-23): Inside each module: drawn wires. Between the P4 and each module: one named bus per module (operator ruling 2026-09-23). Members are local labels BUS.MEMBER (a named KiCad group bus names its members that way); a P4 pin on the far side of U8 joins its bus by tha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
POWER MONITOR (INA228)
COMPUTE (STAMP-P4)
BOARD MONITOR
MOTOR SWITCH (record section 4). TPS48111 datasheet Figure 9-14 topology: back-to- back N-FETs, common source, pre-charge through Q403 and Q402's body diode. Open = open both ways: back-drive never reaches the board, so the regen shunt sizes for the powered 6.8 W case. FETs Q401/Q402: 100 V (58.6 V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
COMPUTE (record section 8; SPEC: no RP2350, the P4 LP core emits quadrature). Stamp-P4 + Stamp-AddOn C6 stacked on top (SDIO G42-G48, not castellated). Fixed pins only: VIN (14) from +5V, the stamp ORs it with its own USB-C 5V and makes SOC_3.3V itself; all GND pads. No reset button: CHIP_EN and G3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
