openvalence/Hardware/(commit log)

2026-09-22 hardware: the physical side of the Valence ecosystem (OSSM Flagship board and everything around it), CERN-OHL-S, KiCad
2026-09-22 flagship: spec skeleton (decisions to make, assumptions tagged) and a rough BOM cost
2026-09-22 flagship spec: 58x58, back heatsink 40x40, through-hole ring, on-board braking resistors, XT30, non-isolated 3.3 V RS485 (rulings 2026-09-22)
2026-09-22 flagship spec: single-sided assembly, top-side brake resistors over filled+capped thermal vias, via-in-pad; BOM lines for 58x58 and the resistor bank
2026-09-22 flagship spec: brake resistor sizing case (overhauling load, half duty), fan as the sustained-abuse cover, temperature policy hook, external-resistor pads as respin insurance
2026-09-22 flagship spec: corrected to the recorded facts -- 36 V bus, 57AIM30 integrated servo, chopper on this board (own design), INA228 5 mOhm on the bus
2026-09-22 flagship: the design record moves here from Nucleus (one home); SPEC becomes a dated rulings ledger that cites it and marks what today supersedes; BOM lines follow the record (60AIM40F/60AIM40, 10 A 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
2026-09-22 flagship: KiCad 10 project skeleton, JLC constraints and 6-layer stackup, LCSC library pulls, stackup arithmetic
    - ossm-flagship.kicad_pcb generated with pcbnew Python: 6 copper layers, 58 x 58 outline,
    JLCPCB multilayer constraints in Board Setup, filled+capped tented vias, rule areas
    center40 (through-hole ban, enforced by the .kicad_dru rule) and back_face (no
    footprints or pads on the heatsink side). kicad-cli pcb drc: 0 violations.
    - ossm-flagship.kicad_pro net classes Default / PWR / RS485; .kicad_dru mechanizes the
    SPEC.md geometry rulings.
    - lib/flagship.*: easyeda2kicad pulls (INA228, XT30PW-M, THVD1450DR, SN74AHCT125PWR,
    PWR263S-35 x2, LM5069, TPS26636 candidates); model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
    [ossm-flagship.kicad_pcb]
2026-09-22 flagship: fab spec as quoted (6L, 1 oz all layers, TG155, white/black, epoxy filled+capped, 0.3 mm vias, OSP or ENIG); project and arithmetic re-cut to match
    Board Setup: 1 oz mins (0.1/0.1), single via size 0.6/0.3, copper 0.035 on all six,
    mask White, silk Black, finish OSP. Net classes and .kicad_dru follow (PWR 5.0 mm,
    floor 4.0 mm). kicad-cli drc: 0 violations. SPEC.md gains the two rulings; stackup.md
    tables re-run for 1 oz (10 A path 5 mm on F.Cu; lateral 6.2 K/W, second order).
    [ossm-flagship.kicad_pcb]
2026-09-22 flagship: root schematic with one sub-sheet per design-record section
    Input protection, motor switch, regen shunt, rails, compute, drive IO, sensing.
    Empty sheets; kicad-cli ERC 0 violations. Created through the KiCad MCP server.
    [compute.kicad_sch, drive-io.kicad_sch, input.kicad_sch, motor-switch.kicad_sch, ossm-flagship.kicad_sch, rails.kicad_sch, regen-shunt.kicad_sch, sensing.kicad_sch]
2026-09-22 flagship: upgrade schematic sheets to the KiCad 10 file format (20260306)
    The MCP server's templates write 20260101; kicad-cli sch upgrade on all eight. ERC 0.
    [compute.kicad_sch, drive-io.kicad_sch, input.kicad_sch, motor-switch.kicad_sch, ossm-flagship.kicad_sch, rails.kicad_sch, regen-shunt.kicad_sch, sensing.kicad_sch]
2026-09-22 gitignore: KiCad 10 local history directory
2026-09-22 flagship: connector and placement rulings (2x XT30 right-angle, stamp centered on an edge with USB out, symmetric bulk caps, JST GH signals); three open items
    [ossm-flagship.kicad_sch]
2026-09-22 flagship: C6 add-on stacks on the stamp (antenna open item resolved); GH harness pre-crimped board side
2026-09-22 flagship: M5Stack Stamp-P4 footprint (official, M5_Hardware KiCad/Footprints/M5Stack.pretty), embedded STEP
    65 SMD pads, no through-hole. No KiCad symbol is published for the P4; built later from M5's schematic.
2026-09-22 flagship: Stamp-P4 symbol, converted from M5Stack's own SchLib (M5_Hardware Products/S013_Stamp-P4)
    65 pins, matches M5's schematic (G35 on pads 36 and 48, as published). Footprint linked to
    flagship:Stamp-P4, reference U. Registered as project library m5stack.
2026-09-22 gitignore: KiCad MCP server backup directory
2026-09-22 flagship: schematic skeleton across all seven sheets
    Candidate ICs placed with cross-sheet nets as global labels and a design note per sheet
    citing the record: LTC4364IS-2 input protection with INA228 Kelvin shunt and mirrored bulk;
    TPS48111 back-to-back motor switch with pre-charge, MOTOR_EN pulldown, INA ALERT hardware
    cut; TLV1805 + TLV431 self-acting regen clamp, 2x TO-263, external connector and
    parallel/replace jumper; 3x TPS54560B bucks (12/5/3.3 V); Stamp-P4 with fixed pins only
    (GPIO assignment follows layout, per ruling); THVD1450 RS485, 74AHCT125 quadrature, drive
    status inputs; INA228, thermistor and fan headers. Connectors are generic placeholders.
    SPEC.md: rulings for no RP235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
    [compute.kicad_sch, drive-io.kicad_sch, input.kicad_sch, motor-switch.kicad_sch, ossm-flagship.kicad_pcb, ossm-flagship.kicad_sch, rails.kicad_sch, regen-shunt.kicad_sch]
2026-09-23 flagship: motor-switch note carries the measured 150 uF drive-side capacitance and the pre-charge numbers
    [compute.kicad_sch, drive-io.kicad_sch, input.kicad_sch, motor-switch.kicad_sch, ossm-flagship.kicad_pcb, ossm-flagship.kicad_sch, rails.kicad_sch, regen-shunt.kicad_sch]
2026-09-23 flagship: restore the schematic skeleton after a KiCad local-history restore emptied the sheets
    A power outage led KiCad to restore sheets from an early local-history snapshot (empty);
    b380537 captured that state by accident. Sheets restored from 61fcb83, verified
    line-identical to KiCad's own _restore_backup copy; 84 symbols across seven sheets,
    ERC unchanged at 190 skeleton-stage items. Restore backups are now gitignored.
    Motor-switch note carries the measured 150 uF drive-side capacitance (hw-x65).
    [compute.kicad_sch, drive-io.kicad_sch, input.kicad_sch, motor-switch.kicad_sch, ossm-flagship.kicad_pcb, ossm-flagship.kicad_sch, rails.kicad_sch, regen-shunt.kicad_sch]
2026-09-23 flagship: input protection latches off (LTC4364-1) with a raw-input-powered fault LED; candidate ICs accepted (SPEC rulings)
    [input.kicad_sch]
2026-09-23 flagship: rails detailed per the TPS54560B datasheet; logic power moved to the stamp's own rails
    Rails: three identical 400 kHz columns (A3 sheet), 4 A each, VIN 20-48 V, UVLO 20/17 V,
    values from the datasheet design procedure (inductor, derated ceramic output, FB, type-II
    comp, B560C catch diode, 4x 2.2u/100V input). Worst on-time 205 ns vs 135 ns minimum.
    Logic power (operator): +5V_SYS = stamp pad 39 (VIN/USB OR) feeds the 74AHCT125, drive
    485_5V and status LED, so USB alone emits quadrature; +3V3_SYS = stamp pad 28 feeds the
    INA228, THVD1450 and all pull-ups. 3.3 V buck is accessory-only (+3V3_ACC). Netlist checked:
    the five power domains are separate. SPEC rulings recorded.
    Co-Authore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
    [compute.kicad_sch, drive-io.kicad_sch, motor-switch.kicad_sch, rails.kicad_sch, sensing.kicad_sch]
2026-09-23 flagship: drop the duplicate GND power flag on the rails sheet (ERC power-output clash)
    [rails.kicad_sch]
2026-09-23 flagship: rails sheet redrawn as wired circuits; SPEC drawing rule (wire it, don't label it)
    Each buck is drawn as one circuit: VIN bus, IC, passives wired to the pins they serve
    (UVLO, RT, boot, compensation, feedback), switch node, catch diode, inductor, output bus.
    Labels only at the sheet boundary (+BUS in, rail out); ground symbols per part.
    Generated from verified pin geometry; the whole-design netlist is identical before and
    after (connectivity unchanged, drawing only).
    [rails.kicad_sch]
2026-09-23 flagship: input fuse F1 (OMNI-BLOK 154 + Nano2 453 15 A, 65 V DC) first in the path; no polyfuse (SPEC ruling)
    [input.kicad_sch]
2026-09-23 flagship: input fuse soldered (Nano2 453 15 A) instead of socketed; SPEC ruling updated
    [input.kicad_sch]
2026-09-23 flagship: motor switch detailed and drawn as a wired circuit (TPS48111 Figure 9-14)
    Back-to-back FETs with the controller rotated so its power pins face the row; every
    setting part wired to its pin; labels only for nets leaving the sheet. Values from the
    datasheet equations: 2 mOhm sense, OC 15.2 A / 10 ms latch-off, SC 30 A, IMON 3.0 V at
    20 A, CBST 470n, UVLO ~23 V, 100 R pre-charge through Q403 + Q402 body diode, MMBT3904
    over-temperature, SMBJ48CA output clamp. INA_ALERT_N now pulls a bus-powered EN divider.
    Verified: all 22 sheet nets match the intended connection table exactly; ERC 0 errors on
    the sheet after typing the TPS48111 pins (PU output, PD passive, FLT open collector).
    Co-Aut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
    [motor-switch.kicad_sch]
2026-09-23 flagship: regen shunt detailed and drawn as a wired circuit
    Power section (R509 || R510 -> JP501 -> Q501, J3 + D501 on the switch node) beside the
    self-acting comparator clamp (TLV1805 + TLV431): ON 44.7 V / OFF 41.7 V, 1 nF filter,
    47 R gate drive; the CLAMP_MON divider doubles as the gate pull-down. Verified: all 10
    sheet nets match the intended table exactly; ERC 0 errors after typing the comparator
    and reference pins.
    [regen-shunt.kicad_sch]
2026-09-23 flagship: Drive IO detailed and drawn wired; connectors left to the operator (named nets)
    RS485 (THVD1450, DE and /RE tied, 120 R DNP, SM712 ESD), quadrature buffers (KiCad
    74AHCT125 per-gate symbol, spare gates disabled and no-connect), three status inputs
    (10k pull-up, 1k series). J4/J5 placeholders removed: every off-board net ends in a
    global label (DRV_485A/B, DRV_PU+/DIR+, DRV_*_IN, +5V_SYS for 485_5V). SM712 pulled
    from LCSC (C12067). Verified: all sheet nets match the intended topology; ERC errors are
    only the four P4-driven inputs awaiting layout pin assignment.
    [drive-io.kicad_sch]
2026-09-23 flagship: Sensing detailed and drawn wired
    INA228 (0x40, Kelvin taps, ALERT = motor-switch EN), I2C pull-ups (fit if absent on the
    stamp), thermistor pull-up + RC into ADC1, fan supply jumper, tach pull-up + series R,
    fan PWM open-drain through a 2N7002 (fan pulls PWM to 5 V; P4 not 5 V tolerant).
    J6/J7 placeholders removed; off-board nets are THERM_IN, FAN_V, FAN_TACH_IN, FAN_PWM_OUT.
    Verified: all 17 sheet nets match the intended table; ERC 0 errors on the sheet.
    [sensing.kicad_sch]
2026-09-23 flagship: input protection detailed (LTC4364-1); real FETs and regen resistors picked
    Input sheet drawn wired from the LTC4364 datasheet Figure 1 topology: 2.5 mOhm / 20 A
    limit, 22 nF HGATE soft ramp, 100 nF timer, 51.5 V output clamp above the regen clamp,
    UV 20 V / OV 50 V, 15 V gate zeners, SMBJ45CA bidirectional input TVS, 27k fault LED.
    Verified: all input nets exact against the intended table; ERC 0 on the sheet.
    Parts: PSMN3R7-100BSE (enhanced-SOA hot-swap D2PAK) in all five power FET positions,
    DMN10H220L pre-charge FET, 3x Vishay D2TO35M 24 R regen resistors with isolated tabs to
    GND. New project symbols with numbered pins matching the footprints: Q_NMOS_D2PAK
    (1 G, 2 D tab, 3 S),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
    [input.kicad_sch, motor-switch.kicad_sch, regen-shunt.kicad_sch]
2026-09-23 flagship: fan supply jumper defaults to 12 V (pre-bridged 1-2, cut and re-bridge for 5 V)
    [sensing.kicad_sch]
2026-09-23 flagship: Kelvin WSK2512 shunts everywhere (LTC4364 sense now 4-terminal), bulk and MLCC parts picked
    R1 (LTC4364, 2.5 mOhm) becomes a 4-terminal shunt with SENSE and OUT on its Kelvin taps;
    R1/R2/R401 all Vishay WSK2512 on the T2.21 mm footprint that value range needs. Bulk:
    2x EEH-ZA1J101P 100 uF 63 V hybrid polymer + 2x GRM32ER72A225KA35L; buck input caps get
    the same MLCC part number. Regen resistors labeled D2TO35M 24 R 2 %. Input nets verified
    exact after regeneration; ERC 0 on every detailed sheet.
    [input.kicad_sch, motor-switch.kicad_sch, rails.kicad_sch, regen-shunt.kicad_sch]
2026-09-23 flagship: regen clamp revised -- UCC27517 driver, 1.4 V hysteresis, SS310 freewheel, clamp LED, CLAMP_MON counting, shunt NTC
    [regen-shunt.kicad_sch]
2026-09-23 flagship: drop the regen gate driver -- TLV1805 drives Q501 directly; switching loss ~0.16 W, not watts
    [regen-shunt.kicad_sch]
2026-09-23 flagship: U1 datasheet link pointed at the -2 listing; now the ADI -1/-2 datasheet, ordering note names LTC4364IS-1#PBF
    [input.kicad_sch]
2026-09-23 flagship: shunts to LCSC stock -- WSK1216 true Kelvin for the INA228, CSS2H 2 mOhm pseudo-Kelvin (net-tied sense pads) for the LTC4364 and motor switch
    [input.kicad_sch, motor-switch.kicad_sch]
2026-09-23 flagship: bulk to 4 x EEH-ZA1J101P (C5/C6 on +BUS); input note tracks the 44.5 V clamp and the ~670 uF inrush
    [input.kicad_sch]
2026-09-23 flagship: state the input hot-swap FET's worst-case short margin (1.9x at max foldback); 2.3 mOhm not stocked, 2 mOhm stands
    [input.kicad_sch]
2026-09-23 flagship: drive connectors (XT30 + GH4 motion / XT30 ext shunt + GH6 comms), HOME and PAIR buttons with EN/BOOT rescue pads, status LED through AHCT125 gate 3, ZO dropped; FEATURES.md
    ZO removal: DRV_ZO / DRV_ZO_IN and R19/R22 existed only on the Drive IO sheet (netlist checked: no other node on either net).
    [compute.kicad_sch, drive-io.kicad_sch]
2026-09-23 flagship: flatten the schematic to one wired A1 sheet (input left, P4 middle, outputs right, section boxes, notes panel); provisional P4 pin map; connectors placed
    Sub-sheet deletion: the root sheet has no (sheet) entries left and no .kicad_* or .md file references the seven sub-sheet files. Netlist compared against the hierarchical design: every pre-existing pin keeps its connections; the only changes are the new P4 pin assignments, the I2C pin swap, pad 48 no-connect, the button pin order, and the new connectors.
    [compute.kicad_sch, drive-io.kicad_sch, input.kicad_sch, motor-switch.kicad_sch, ossm-flagship.kicad_sch, rails.kicad_sch, regen-shunt.kicad_sch, sensing.kicad_sch]
2026-09-23 flagship: tidy every schematic section (compact layouts, no overlapping text, grounds bused, PRE_G drawn as a wire); netlist verified identical
    Eight per-section passes applied one at a time to the flat sheet, each checked against the pre-tidy netlist (identical after every step). ERC: only the spare Stamp-P4 pins remain unconnected.
    [ossm-flagship.kicad_sch]
2026-09-23 flagship: BOM priced from the schematic (LCSC/DigiKey/M5Stack, 2026-09-23): $134/board at 5, $111/board at 40 incl. PCB; open items listed
2026-09-23 flagship: J8 firmware probe header (QUAD_A, GND, DBG, QUAD_B) + R602 1k on spare G50 for a DBG trigger pin
    [ossm-flagship.kicad_sch]
2026-09-23 flagship: compact the schematic (sections pulled together, notes beside fan/drive, page 711 x 523 mm); netlist verified identical
    [ossm-flagship.kicad_sch]
2026-09-23 flagship: power FETs -> IPB042N10N3G x5 (C802 timer 22 nF C0G keeps Q1 in SOA), bulk -> 4 x EEH-ZA1J820P 82 uF 63 V; BOM ~$89/board at 5, ~$65 at 40
    [ossm-flagship.kicad_sch]
2026-09-23 flagship: bus-powered OVP trip (51 V zener + NPN on the TPS48111 EN node) cuts motor power on bus overvoltage, no firmware needed
    [ossm-flagship.kicad_sch]
2026-09-23 flagship: open item -- external wired E-stop (3-pin, fail-safe on a missing cable, dummy-plug bypass)
2026-09-23 flagship: 24-36 V input (R408 30.1k: motor UVLO 19.6/18.4 V; R803 17.8k: LTC4364 UV 18.1 V); motor pairing recorded; C401 note corrected to 1u
    [ossm-flagship.kicad_sch]
2026-09-23 flagship: heatsink ruling -- 40x40x6 copper on thermal tape, floating, flat masked bottom; closes the sink open items
2026-09-23 flagship: regen bank 24 x 200R anti-surge 2512; fan 3-pin, 5 V default, high-side PWM
    Regen: R509-R511 (3 x D2TO35M 24R, unstocked) replaced by R521-R544, 24 x UniOhm
    AS122WJ0201T4E 200R 2512 in parallel = 8.33 R (LCSC C2770484, ~$2/board). No tabs,
    so the bank no longer touches GND. BOM totals now include it.
    Fan: J6 GH4 -> GH3 (1 GND, 2 +V, 3 TACH). Q702 AO3401A high-side on the fan's +V
    so the tach ground stays solid; Q701 2N7002 drives its gate through R703 470R
    against R702 1k (Vgs -8.2 V on the 12 V setting, under the +-12 V rating).
    D701 B5819W flyback. JP2 now defaults to 5 V.
    Netlist diffed per pin against the previous baseline: only these changes.
    ERC: 29 errors, all unused Stamp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
    [ossm-flagship.kicad_sch]
2026-09-23 flagship: fan supply filtered to DC with damping and polyfuse; connector short protection
    Fan: L701 100 uH + C701 22 uF after Q702 (D701 freewheels) so the tach is valid
    at every speed; R704 1R + C702 100 uF damp the LC (simulated hard-step overshoot
    0-6 %, was +60-75 %); F701 0.5 A polyfuse in the fan feed.
    Connectors: F601 0.1 A polyfuse on the COMMS 5 V out; R603/R604 180R on the
    MOTION pulse outputs; R605/R606 1k on the probe-header taps (J8 moved).
    ERC: 29 errors, all unused Stamp-P4 (U8) pins, same as before.
    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
    [ossm-flagship.kicad_sch]
2026-09-23 flagship: external wired E-stop (COM/NC/NO, hardware trip, unplugged-only single-session bypass)
    J9 GH3 with R901/R902 2.2k pull-ups, C901/C902, D901 PESD3V3S2UT. NC open drives
    Q901 onto the motor-switch EN wired-OR node (with the bus OVP and INA ALERT): a
    hardware stop. NC/NO read on G39/G30 through 1k. Bypass G29 -> Q903 in series
    with Q902 (gated by NO open), so only an unplugged cable can be masked; R906
    pull-down clears it on every reset. Resolves the SPEC open item.
    Netlist diffed per pin against the previous baseline: only additions; U8 pins
    31/53/54 leave the unconnected list. ERC: 26 errors, all unused Stamp-P4 pins.
    [ossm-flagship.kicad_sch]
2026-09-23 flagship: ruling -- budget-build bypass links across the LTC4364 input protection and the motor switch (not yet drawn; warnings in the docs phase)
2026-09-23 flagship: LP pins quadrature-only ruling; close LPG map (scope-verified), I2C-sharing, via plating (JLC 18 um, stackup redone), drive-current (moved to firmware) open items
2026-09-23 flagship: LP pins carry quadrature only (six signals moved to HP GPIOs); budget-build bypass links drawn
    Pins: INA228 SDA LPG9->G34, SCL LPG11->G36, LED_DATA LPG2->G26, FAN_PWM
    LPG13->G27, FAN_TACH LPG6->G38, BTN_PAIR LPG4->G52; LPG3/LPG5 keep QUAD_A/B and
    every other LPG pin is unused. Strap safety per the Stamp-P4 schematic and
    ESP32-P4 DS/TRM (SPEC row). DSI GND bus nudged to free the G52 lane.
    Links: JP801 (bypasses the LTC4364 stage), JP401 (bypasses the motor switch),
    flagship:Link_Wire_15A footprint, DNP and out of the BOM.
    Netlist diffed per pin: only the two links and the six pin moves. ERC: 26
    errors, all unused Stamp-P4 pins.
    [ossm-flagship.kicad_sch]
2026-09-23 flagship: optional accessory breakouts on the spare LP pads (HP-driven); LP rule restated
    ACCESSORIES section: PUMP (12 V via 1.25 A polyfuse + PWM on LPG13), EXT PWM
    (LPG2, signal only), BUS OUT (+BUS via 2 A 60 V polyfuse), NEOPIXEL OUT chained
    after D5 (5 V via 1 A polyfuse), BUTTONS (HOME/PAIR parallel + AUX1/AUX2 on
    LPG4/LPG6, 10k pull-ups, 1k, ESD), QWIIC on its own I2C bus (LPG11/LPG9, 2.2k),
    GPIO 2x6 (HP UART on LPG14/15, IO1-6 on LPG12/10/8/7/1/0, 220R each).
    Connectors are placeholders. LP core still drives QUAD_A/B only; quad jitter
    under hammered accessory I/O is Nucleus val-091.18.
    Netlist diffed per pin: additions only; the 14 LP pads leave the unconnected
    list. ERC: 12 errors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
    [ossm-flagship.kicad_sch]
2026-09-23 flagship: ruling -- input floor stays 24 V; USB-C PD EPR 28 V/140 W is in range (power profile + LTC stage fitted), 20 V PD is not
2026-09-23 flagship: CH32V003 board monitor (rail/input/motor-switch watch, FAULT onto EN) + firmware-tightenable regen trim; DBG to G37
    U12 CH32V003F4U6 on the INA228 I2C bus: 8 ADC channels (VIN_RAW, MOTOR_V+,
    +12V, +5V, +3V3_ACC, +5V_SYS, CLAMP_MON, SHUNT_TEMP), FAULT_N open-drain into
    the motor-switch EN wired-OR, CLAMP_TRIM PWM into U3 +IN (R502 10k -> 12.1k:
    duty 0 = 44.5 V ceiling, reset = 43.5 V, full = 24.5 V; firmware can only
    lower it). P4 G50 programs it over SWIO; rescue test pads. DBG moved G50 -> G37.
    Cross-section links drawn as global labels (operator's new rule).
    Netlist diffed per pin: additions plus the DBG move only. ERC: 11 errors, all
    unused Stamp-P4 pins.
    [ossm-flagship.kicad_sch]
2026-09-23 flagship: restyle -- one named bus per module from the P4 (MSW, REGEN, I2C, FAN, DRV, ESTOP, UI, ACC)
    Presentation only. Long inter-section wires replaced by per-module buses with
    BUS.MEMBER-labeled stubs; wiring inside modules unchanged. Netlist diffed per
    pin: zero pins changed net-mates, zero component changes; 41 nets renamed to
    functional names. ERC identical to before (11 errors, all unused Stamp-P4 pins).
    [ossm-flagship.kicad_sch]
2026-09-23 flagship: 3.3 V buck -> AMS1117-3.3 LDO off +5V; accessory 5 V split-fused; BUS OUT taps VIN_RAW
    Removed U7 TPS54560B and its dedicated parts (L3, D4, C301-C310, R301-R306;
    net proof in the change log). Added U13 AMS1117-3.3 (+5V -> +3V3_ACC) with
    C1301/C1302; F1004 now fed from +3V3_ACC (3V3_OUT), F1006 0.5 A for the GPIO
    header 5 V (5V_GPIO), F1003 feeds the Neopixel only (5V_NEO). F1005 (BUS OUT)
    input moved from +BUS to VIN_RAW: a loopback of the input, no regen.
    Netlist diffed per pin: only these changes. ERC: 11 errors, all unused
    Stamp-P4 pins; U7's own pin warnings gone.
    [ossm-flagship.kicad_sch]
2026-09-24 flagship: operator layout pass (notes panel moved off-frame, sections shifted) + cleanup
    Operator's hand edits in KiCad, then: two dangling 45-degree stubs removed and
    the orphaned ACC.EXT_PWM / ACC.PUMP_PWM wires trimmed back to their labels
    (the ACC bus segment they tapped was deleted); the operator's re-edited
    Stamp-P4 symbol written back to lib/m5stack.kicad_sym so the embedded copy and
    the library match again (65 pins identical, fields/graphics only).
    Netlist diffed per pin against 05bd6d9: zero changes. ERC identical to 05bd6d9.
    [ossm-flagship.kicad_sch]
2026-09-24 flagship: INA228 shunt R2 moved after the motor switch (motor current only); VBUS on MOTOR_V+
    Q402 -> SW_OUT -> R2 -> MOTOR_V+ -> J2; JP401 lands on SW_OUT (before R2);
    R1 pad 1 joins +BUS; U11 VBUS on MOTOR_V+; monitor channel R1106 moved to +BUS;
    POWER MONITOR relocated beside J2 with R24/R25. Kelvin pair as INA_SENSE_P/N
    labels (route as a pair on the PCB).
    Netlist diffed per pin: exactly the ruled change. ERC identical (53).
    [ossm-flagship.kicad_sch]
2026-09-24 flagship: pump eFuse (TPS259541, 2.5 A) + BUS OUT removed; layout: bucks stacked, OVP trip inside MOTOR SWITCH, thermistor moved
    Electrical: F1001 polyfuse -> U14 TPS259541DSGR (R_ILM 806R = 2.52 A, EN
    64.9k/10k = 9.0 V, dVdt 3.3 nF, FLT -> U12 PC0); J16/F1005 BUS OUT deleted.
    New local symbol flagship:TPS259541DSGR (pinout from TI SLVSE57C).
    Layout (connectivity-neutral): BUCK RAILS 12 V / 5 V / LDO stacked; bus OVP
    trip (D402/R413/R414/Q405) moved inside MOTOR SWITCH; TH501/R512 moved beside
    the CLAMP_MON divider.
    Netlist diffed per pin: only the eFuse/BUS OUT changes; the layout passes are
    zero-change. ERC: 11 errors (unused Stamp-P4 pins, unchanged); +9 pin_to_pin
    warnings from U14's un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
    [ossm-flagship.kicad_sch]
